arsia452/Cyberdeck_TD/CyberdeckKeyboard/production/bom.csv

Designator | Footprint | Quantity | Value | LCSC Part #
C1 | 0603 | 1 | 100nF
C16, C17, C20 | 0603 | 3 | 4.7uF
C18 | 0603 | 1 | 1uF
C19, C26, C27 | 0603 | 3 | 10uF
C3, C5 | 0603 | 2 | 12pF
D1, D10, D11, D12, D13, D14, D15, D16, D17, D18, D19, D2, D20, D21, D22, D23, D24, D25, D26, D27, D28, D29, D3, D30, D31, D32, D33, D34, D35, D36, D37, D38, D39, D4, D40, D41, D42, D43, D44, D45, D46, D47, D48, D49, D5, D50, D51, D52, D53, D54, D55, D56, D57, D58, D59, D6, D60, D61, D62, D63, D7, D8, D9 | Diode_SOD-123 | 63 | ~
D64 | 1206 | 1 | LED Blue
D65 | 1206 | 1 | LED Orange
J1 | SolderWirePad_1x01_SMD_2x4mm | 1 | GND_Pad_TKPD
J2 | USB_C_Receptacle_GCT_USB4105-xx-A_16P_TopMnt_Horizontal | 1 | USB C Recepticle
J3 | JST_PH_B2B-PH-K_1x02_P2.00mm_Vertical | 1 | Conn_01x02
J5 | SolderWirePad_1x01_SMD_2x4mm | 1 | SCL_Pad_TKPD
J6 | SolderWirePad_1x01_SMD_2x4mm | 1 | SDA_Pad_TKPD
J7 | SolderWirePad_1x01_SMD_2x4mm | 1 | VCC_Pad_TKPD
JP1 | SolderJumper-2_P1.3mm_Open_Pad1.0x1.5mm | 1 | Charge Boost
L6 | 0603 | 1 | 10uH
R1 | 0603 | 1 | 2.2Ω
R10, R3, R4, R5 | 0603 | 4 | 10kΩ
R2 | 0603 | 1 | 1kΩ
R6 | 0603 | 1 | 2kΩ
R7 | 0603 | 1 | 10MΩ
R8 | 0603 | 1 | 5.1kΩ
R9 | 0603 | 1 | 5.1κΩ
S1, S10, S11, S12, S13, S14, S15, S16, S17, S18, S19, S2, S20, S21, S22, S23, S24, S25, S26, S27, S28, S29, S3, S30, S31, S33, S35, S36, S37, S38, S39, S4, S40, S41, S42, S43, S44, S45, S46, S47, S48, S49, S5, S50, S51, S52, S53, S54, S55, S56, S57, S58, S59, S6, S60, S61, S62, S63, S7, S8, S9 | Choc_V1V2_1.00u | 61 | ~
SW1 | SW_SPST_CK_RS282G05A3 | 1 | RST_SW
U2 | VQFN-16-1EP_3x3mm_P0.5mm_EP1.6x1.6mm | 1 | BQ24075RGT
U3 | SOT-23-5 | 1 | XC6220B331MR
Y3 | Crystal_SMD_2012-2Pin_2.0x1.2mm | 1 | 32.768kHz FC-12M
