arsia452/Cyberdeck_TD/1217AS-H-4R7N_P3/1217AS-H-4R7N_P3.step

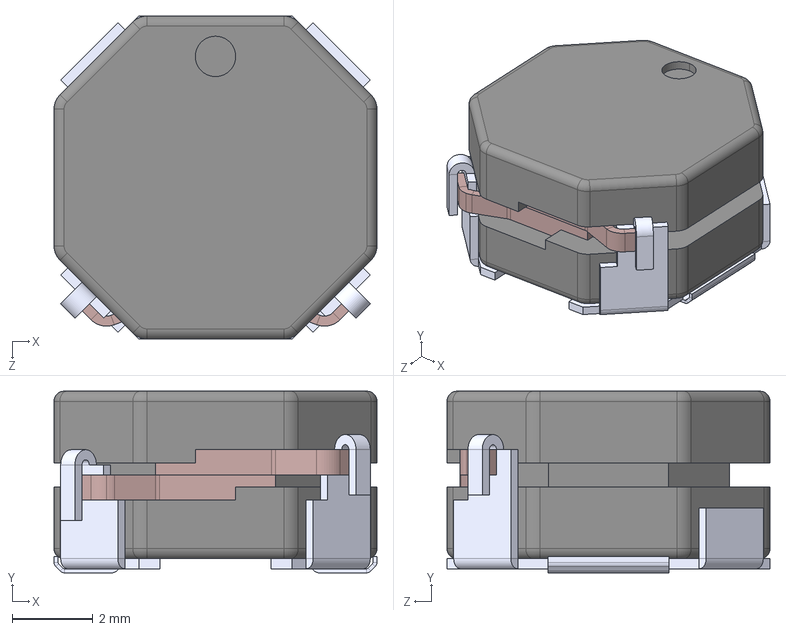
[picture p1: CAD file, 2026-10-16]
1217AS-H-4R7N_P3/1217AS-H-4R7N_P3.step
8.00 x 4.50 x 8.00 mm
