arsia452/Cyberdeck_TD/3D_models/SO-DIMM.stp

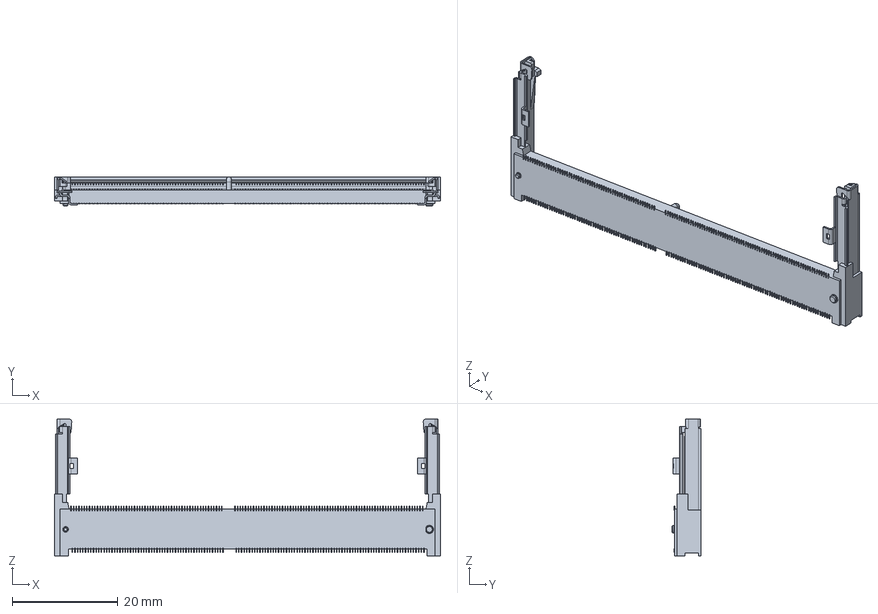
[picture p2: CAD file, 2026-10-16]
3D_models/SO-DIMM.stp
73.0 x 5.55 x 25.9 mm
