arsia452/Cyberdeck_TD/Cyberdeck_TD_Carrier/FDMC8327L/WDFN8_511DR_OSI.step

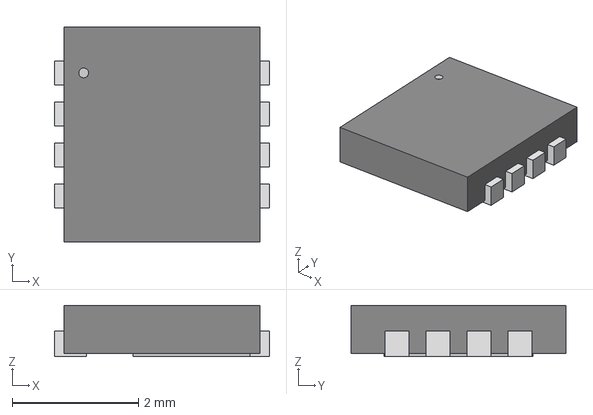
[picture p3: CAD file, 2026-10-16]
Cyberdeck_TD_Carrier/FDMC8327L/WDFN8_511DR_OSI.step
3.40 x 3.40 x 0.815 mm
