arsia452/Cyberdeck_TD/Cyberdeck_TD_Carrier/VLS6045EX_4R7M/IND_VLS6045EX-4R7M_TDK.step

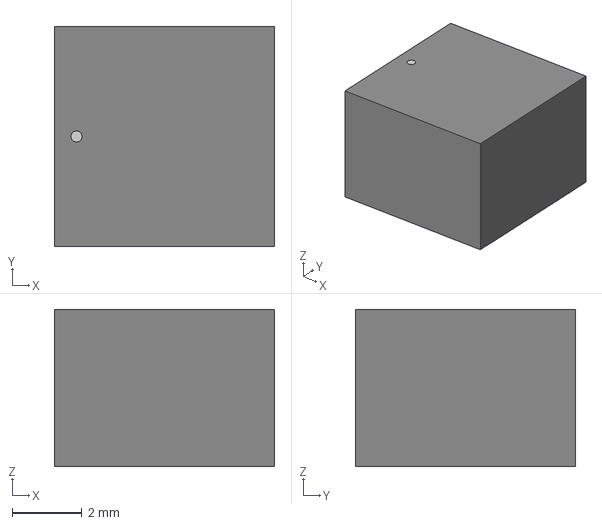
[picture p4: CAD file, 2026-10-16]
Cyberdeck_TD_Carrier/VLS6045EX_4R7M/IND_VLS6045EX-4R7M_TDK.step
6.30 x 6.30 x 4.50 mm
