arsia452/Cyberdeck_TD/CyberdeckKeyboard/CyberdeckKeyboard.step

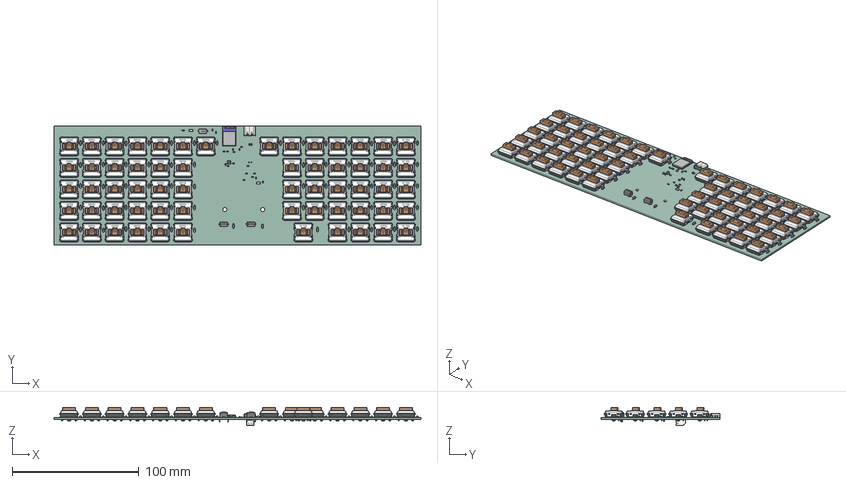
[picture p5: CAD file, 2026-10-16]
CyberdeckKeyboard/CyberdeckKeyboard.step
290.0 x 94.0 x 14.6 mm
Diode_SOD-123 x 63
Choc_V1 x 61
USB_C_Receptacle_GCT_USB4105-xx-A_16P_TopMnt_Horizontal
SW_PUSH_1P1T_6x3.5mm_H4.3_APEM_MJTP1243 x 2
R_0603_1608Metric x 10
C_0603_1608Metric x 10
Raytac_MDBT50Q
SOT-23-5
LED_1206_3216Metric x 2
L_0603_1608Metric
SW_SPST_CK_RS282G05A3
JST_PH_S2B-PH-K_1x02_P2.00mm_Horizontal
CyberdeckKeyboard_PCB
