arsia452/Cyberdeck_TD/3D_models/MDT420E02001.step

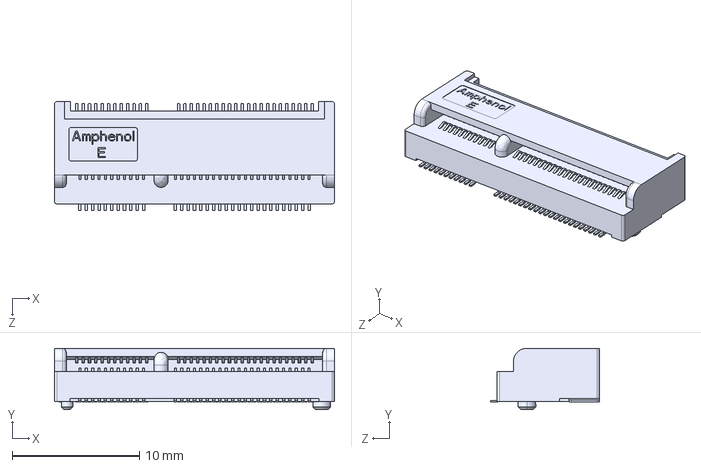
[picture p7: CAD file, 2026-10-16]
3D_models/MDT420E02001.step
22.0 x 4.80 x 8.55 mm
