arsia452/Cyberdeck_TD/3D_models/2086581001.step

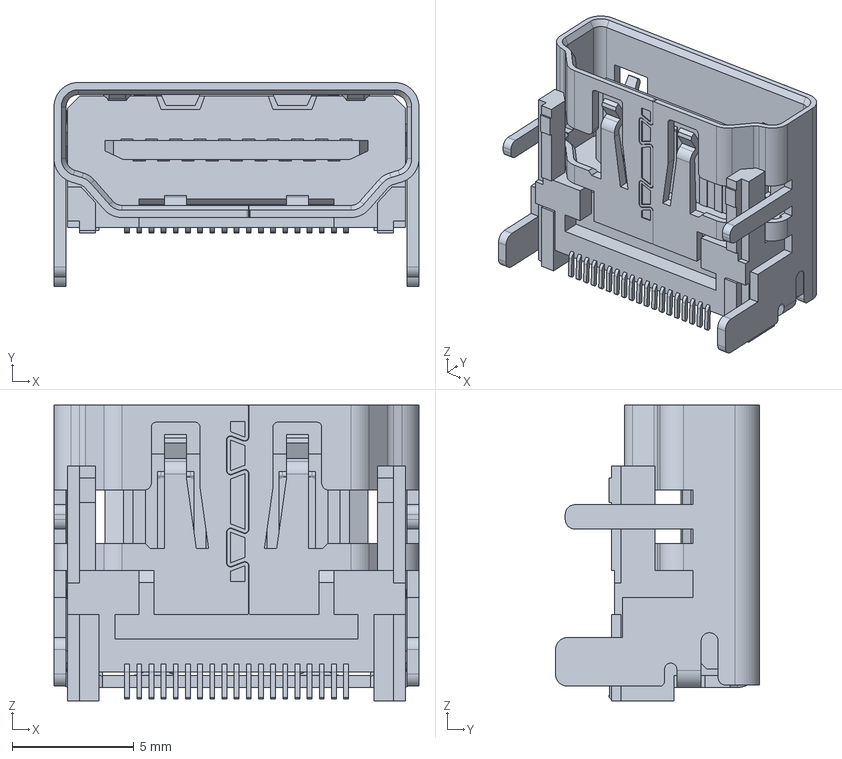
[picture p8: CAD file, 2026-10-16]
3D_models/2086581001.step
15.0 x 8.38 x 12.2 mm
