arsia452/Cyberdeck_TD/Cyberdeck_TD_Carrier/Cyberdeck_TD_Carrier.kicad_pcb

## KiCad design Cyberdeck_TD_Carrier/Cyberdeck_TD_Carrier.kicad_pcb (2026-10-19)

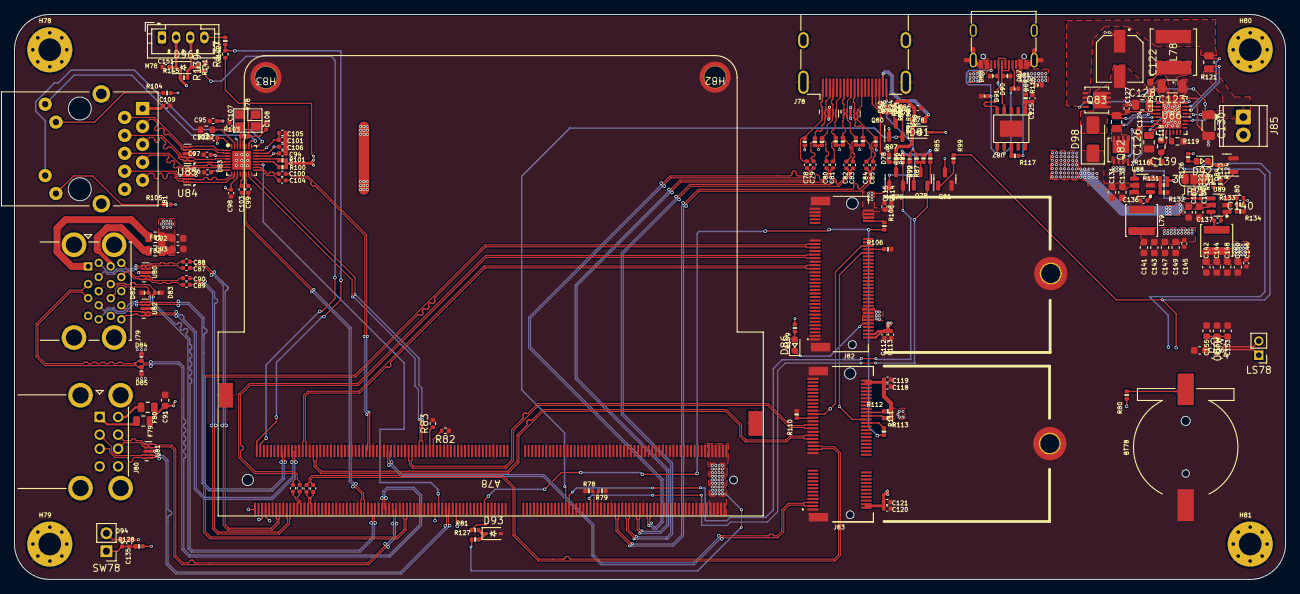
[picture p9: board Cyberdeck_TD_Carrier.kicad_pcb from above]

Board: 4 copper layers, 180.0 x 80.0 mm, 205 parts (0 on the bottom side), 166 nets.

Parts:
A78: LattePanda_Mu; LattePanda_Module_H8.0mm_Horizontal
BT78: Battery_Cell; Battery_Holder_CR1220_S8411-45R
C78, C79, C80, C81, C82, C83, C84, C85, C86, C87, C88, C89, C90, C94, C95, C96, C97, C98, C99, C100, C101, C102, C103, C104, C106, C109, C113, C115, C119, C121, C136, C137, C145, C146, C151: 100nF/50V; C_0402_1005Metric
C91, C92, C93, C131, C132, C133, C134, C141, C142, C143, C144, C147, C148, C149, C150: 22uF/10V; C_0603_1608Metric
C105, C112, C114, C118, C120: 10uF/10V; C_0402_1005Metric
C107, C108, C139, C140: 12pF/50V; C_0402_1005Metric
C110, C111, C116, C117: 220nF/50V; C_0402_1005Metric
C122: 47uF; CAP_EEEFH1E470XL
C123, C130: 10uF; C_1206_3216Metric
C124, C127: 0.1uF; C_0402_1005Metric
C125, C135: 1uF/16V; C_0402_1005Metric
C126: 1uF; C_0805_2012Metric
C128: 10uF; C_0805_2012Metric
C129: 22nF; C_0603_1608Metric
C153: 100uF; C_0603_1608Metric
C154: 10uF; C_0603_1608Metric
C155, C156: 1uF; C_0603_1608Metric
D78, D79, D80, D82, D83, D84, D85, D87, D88, D94: ESD5V0B03; D_0402_1005Metric
D81, D96: 1N5819WS; D_SOD-323
D86, D92: LED_G; LED_0603_1608Metric
D89, D90, D91: PESD24VS1UL-N; D_0402_1005Metric
D93: 3V3 Izt=5mA; D_SOD-323
D98: D_TVS; D_SMA
F78: 6V/50mA; R_0603_1608Metric
F79, F80: 6V/1A; Fuse_0805_2012Metric
F81: 6V/2A; R_0805_2012Metric
F82: 6V/2A; Fuse_0805_2012Metric
H78, H79, H80, H81: MountingHole_Pad; MountingHole_3.2mm_M3_Pad_Via
H82, H83: MountingHole_Pad; MountingHole_3mm_M2_Pad_TopOnly
H84, H85: MountingHole_M2.0; MountingHole_2.7mm_M2.5_DIN965_Pad_TopOnly
J78: HDMI_A; HDMI_A_Molex_208658-1001_Horizontal
J79: USB3_A_Stacked; USB3_A_Molex_48406-0001_Horizontal_Stacked
J80: USB_A_Stacked; USB_A_CUI_UJ2-ADH-TH_Horizontal_Stacked
J81: RJ45_RB1-125B8G1A; RJ45_UDE_RB1-125B8G1A
J82: Bus_M.2_Socket_M; PCIe_M.2_Connectors_P=0.5mm_H=4.2mm_KeyM
J83: Bus_M.2_Socket_E; PCIe_M.2_Connectors_P=0.5mm_H=4.2mm_KeyE
J84: USB_C_Receptacle_USB2.0; USB_C_Receptacle_G-Switch_GT-USB-7010ASV
J85: BAT_TERM; TerminalBlock_TE_282834-2_1x02_P2.54mm_Horizontal
JP78: SolderJumper_3_Open; SolderJumper-3_P1.3mm_Bridged2Bar12_RoundedPad1.0x1.5mm_Num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
L78: 4.7uH; IND_VLS6045EX-4R7M_TDK
L79, L80: 2.2uH/4.3A; L_Sunlord_SWPA4020S
LS78: Speaker; PinHeader_1x02_P2.00mm_Vertical
M78: Fan_4pin; JST_PH_B4B-PH-K_1x04_P2.00mm_Vertical
Q78, Q84: 2N7002; SOT-23
Q79, Q80, Q81: 2SK3018; SOT-23
Q82, Q83: FDMC8327L; WDFN8_511DR_OSI
R78, R79, R125: 100K/1%; R_0402_1005Metric
R80, R92, R115, R123: 1K/1%; R_0402_1005Metric
R81, R82, R83, R100, R101, R112, R113, R117, R124, R132: 10K/1%; R_0402_1005Metric
R84, R86, R95, R98, R99, R109, R126, R127: 2.2K/1%; R_0402_1005Metric
R85, R103: 1M/1%; R_0402_1005Metric
R87, R133, R139, R141: 21.5K/1%; R_0402_1005Metric
R88, R89, R90, R91, R93, R94, R96, R97, R104, R105: 470R/1%; R_0402_1005Metric
R102: 2.49K/1%; R_0603_1608Metric
R106, R108, R110, R111: 0R/1%; R_0402_1005Metric
R114: 6.8mΩ; R_0805_2012Metric
R116, R118: 10kΩ; R_0603_1608Metric
R119: 63.4kΩ; R_0603_1608Metric
R121: 10mΩ; R_0805_2012Metric
R122, R128, R142: 100R/1%; R_0402_1005Metric
R131: 75K/1%; R_0402_1005Metric
R134, R137, R145: 4.7K/1%; R_0402_1005Metric
SW78: PWR_BTN; PinHeader_1x02_P2.54mm_Vertical
U78, U79: TPAZ1023-04F; Diodes_UDFN-10_1.0x2.5mm_P0.5mm
U80, U81, U82, U84, U85: ULC0524P; Diodes_UDFN-10_1.0x2.5mm_P0.5mm
U83: RTL8111H-CG-RH; QFN-32-1EP_4x4mm_P0.4mm_EP2.65x2.65mm
U86: LTC4162-L42; 05-08-1712_ADI-L
U87: CH224K; ESSOP-10-1EP_3.9x5mm_P1.0mm_EP3.2x2.3
U88, U89: SY8253ADC; TSOT-23-6
U90: MAX98365AEWC+; 21-100536_W121D1&plus_1_MXM
Y78: 25MHz; Crystal_SMD_3225-4Pin_3.2x2.5mm

Connections:
5V_HDMI_VCC: C86.1, D81.1 (K), F78.1, R95.1, R98.1
+1V0: C94.2, C95.2, C96.2, C97.2, C101.2, C105.2, U83.3 (AVDD10), U83.8 (AVDD10), U83.22 (DVDD10), U83.24 (REGOUT), U83.30 (AVDD10)
+3V3: C98.2, C102.2, C106.2, C112.2, C113.2, C114.2, C115.2, C118.2, C119.2, C120.2, C121.2, C140.1, C142.2, C144.2, C146.1, C148.2, C150.2, J82.2 (3.3V), J82.4 (3.3V), J82.12 (3.3V), J82.14 (3.3V), J82.16 (3.3V), J82.18 (3.3V), J82.70 (3.3V), J82.72 (3.3V), J82.74 (3.3V), J83.2 (3.3V), J83.4 (3.3V), J83.72 (3.3V), J83.74 (3.3V), L80.2, Q78.1 (G), Q79.1 (G), Q80.1 (G), R84.1, R85.1, R86.1, R100.1, R101.1, R104.2, R105.2, R109.2, R112.2, R113.1, R126.2, R133.2, R137.1, U83.11 (AVDD33), U83.23 (VDDREG), U83.32 (AVDD33)
+5V: C91.2, C92.2, C93.2, C139.1, C141.2, C143.2, C145.1, C147.2, C149.2, C151.1, D81.2 (A), D96.1 (K), F79.1, F80.1, F81.1, F82.1, L79.2, M78.2 (+), R131.2, R145.1
+BATT: A78.115 (VBAT), R80.1
/Fan_Temp/FAN_1_PWM: A78.2 (FAN1_PWM), R137.2, R142.1
/Fan_Temp/FAN_1_TAC: A78.4 (FAN1_TAC), R139.1, R141.2
/Gigabit Ethernet/GbE_PCIe_CLK+: A78.94 (REFCLK4+), U83.15 (REFCLK_P)
/Gigabit Ethernet/GbE_PCIe_CLK-: A78.96 (REFCLK4-), U83.16 (REFCLK_N)
/Gigabit Ethernet/GbE_PCIe_RX+: A78.64 (HSIO6_RX+), C104.2
/Gigabit Ethernet/GbE_PCIe_RX-: A78.66 (HSIO6_RX-), C100.2
/Gigabit Ethernet/GbE_PCIe_TX+: A78.61 (HSIO6_TX+), C103.2
/Gigabit Ethernet/GbE_PCIe_TX-: A78.63 (HSIO6_TX-), C99.2
/Gigabit Ethernet/HSI+: C103.1, U83.13 (HSIP)
/Gigabit Ethernet/HSI-: C99.1, U83.14 (HSIN)
/Gigabit Ethernet/HSO+: C104.1, U83.17 (HSOP)
/Gigabit Ethernet/HSO-: C100.1, U83.18 (HSON)
/Gigabit Ethernet/LED1_1000: J81.L4, U83.26 (LED1)
/Gigabit Ethernet/LED2_ACT: J81.L2, U83.25 (LED2)
/Gigabit Ethernet/MDI0+: J81.R2 (TD1+), U83.1 (MDIP0), U85.5, U85.6 (NC)
/Gigabit Ethernet/MDI0-: J81.R3 (TD1-), U83.2 (MDIN0), U85.4, U85.7 (NC)
/Gigabit Ethernet/MDI1+: J81.R4 (TD2+), U83.4 (MDIP1), U85.2, U85.9 (NC)
/Gigabit Ethernet/MDI1-: J81.R5 (TD2-), U83.5 (MDIN1), U85.1, U85.10 (NC)
/Gigabit Ethernet/MDI2+: J81.R6 (TD3+), U83.6 (MDIP2), U84.5, U84.6 (NC)
/Gigabit Ethernet/MDI2-: J81.R7 (TD3-), U83.7 (MDIN2), U84.4, U84.7 (NC)
/Gigabit Ethernet/MDI3+: J81.R8 (TD4+), U83.9 (MDIP3), U84.2, U84.9 (NC)
/Gigabit Ethernet/MDI3-: J81.R9 (TD4-), U83.10 (MDIN3), U84.1, U84.10 (NC)
/HDMI/DDC_SCL: D78.2 (A2), J78.15 (SCL), Q79.3 (D), R95.2
/HDMI/DDC_SDA: D80.2 (A2), J78.16 (SDA), Q80.3 (D), R98.2
/HDMI/DDI_B_DDC_SCL: A78.171 (DDIB_DDC_SCL), Q79.2 (S), R86.2
/HDMI/DDI_B_DDC_SDA: A78.169 (DDIB_DDC_SDA), Q80.2 (S), R84.2
/HDMI/DDI_B_HPD: A78.183 (DDIB_HPD), Q78.2 (S), R85.2
/HDMI/DDI_B_TX0+: A78.217 (DDIB_TX0+), C78.1
/HDMI/DDI_B_TX0-: A78.215 (DDIB_TX0-), C79.1
/HDMI/DDI_B_TX1+: A78.211 (DDIB_TX1+), C80.1
/HDMI/DDI_B_TX1-: A78.209 (DDIB_TX1-), C81.1
/HDMI/DDI_B_TX2+: A78.205 (DDIB_TX2+), C82.1
/HDMI/DDI_B_TX2-: A78.203 (DDIB_TX2-), C83.1
/HDMI/DDI_B_TX3+: A78.199 (DDIB_TX3+), C84.1
/HDMI/DDI_B_TX3-: A78.197 (DDIB_TX3-), C85.1
/HDMI/HPD: D79.2 (A2), J78.19 (HPD), R92.2
/HDMI/TMDS_CK+: C84.2, J78.10 (CK+), R89.1, U79.4, U79.7 (NC)
/HDMI/TMDS_CK-: C85.2, J78.12 (CK-), R88.1, U79.5, U79.6 (NC)
/HDMI/TMDS_D0+: C82.2, J78.7 (D0+), R91.1, U79.1, U79.10 (NC)
/HDMI/TMDS_D0-: C83.2, J78.9 (D0-), R90.1, U79.2, U79.9 (NC)
/HDMI/TMDS_D1+: C80.2, J78.4 (D1+), R94.1, U78.4, U78.7 (NC)
/HDMI/TMDS_D1-: C81.2, J78.6 (D1-), R93.1, U78.5, U78.6 (NC)
/HDMI/TMDS_D2+: C78.2, J78.1 (D2+), R97.1, U78.1, U78.10 (NC)
/HDMI/TMDS_D2-: C79.2, J78.3 (D2-), R96.1, U78.2, U78.9 (NC)
/LattePanda Module/HSIO_0_TX+: A78.13 (HSIO0_TX+), C88.1
/LattePanda Module/HSIO_0_TX-: A78.15 (HSIO0_TX-), C87.1
/LattePanda Module/HSIO_1_TX+: A78.19 (HSIO1_TX+), C90.1
/LattePanda Module/HSIO_1_TX-: A78.21 (HSIO1_TX-), C89.1
/LattePanda Module/HSIO_2_RX+: A78.28 (HSIO2_RX+), J82.43 (PERp0/SATA-B-)
/LattePanda Module/HSIO_2_RX-: A78.30 (HSIO2_RX-), J82.41 (PERn0/SATA-B+)
/LattePanda Module/HSIO_2_TX+: A78.25 (HSIO2_TX+), C110.1
/LattePanda Module/HSIO_2_TX-: A78.27 (HSIO2_TX-), C111.1
/LattePanda Module/HSIO_3_RX+: A78.34 (HSIO3_RX+), J83.41 (PERp0)
/LattePanda Module/HSIO_3_RX-: A78.36 (HSIO3_RX-), J83.43 (PERn0)
/LattePanda Module/HSIO_3_TX+: A78.31 (HSIO3_TX+), C116.1
/LattePanda Module/HSIO_3_TX-: A78.33 (HSIO3_TX-), C117.1
/LattePanda Module/REFCLK0+: A78.85 (REFCLK0+), J82.53 (REFCLKn)
/LattePanda Module/REFCLK0-: A78.87 (REFCLK0-), J82.55 (REFCLKp)
/LattePanda Module/REFCLK3+: A78.88 (REFCLK3+), J83.47 (REFCLKp0)
/LattePanda Module/REFCLK3-: A78.90 (REFCLK3-), J83.49 (REFCLKn0)
/LattePanda Module/SLS_S3: A78.7 (SLS_S3), JP78.3 (B)
/LattePanda Module/SUSCLK_WIFI: A78.131 (SUSCLK), R108.2, R111.2
/LattePanda Module/USB_2_P7+: A78.76 (USB2_P7+), J83.3 (USB_D+)
/LattePanda Module/USB_2_P7-: A78.78 (USB2_P7-), J83.5 (USB_D-)
/LattePanda Module/~PWR_SW: A78.1 (~PWRBTN), R128.2
/M.2 E&M Key/CON_PCIE_TX_0+: C116.2, J83.35 (PETp0)
/M.2 E&M Key/CON_PCIE_TX_0-: C117.2, J83.37 (PETn0)
/M.2 E&M Key/CON_PCIE_TX_1+: C110.2, J82.49 (PETp0/SATA-A+)
/M.2 E&M Key/CON_PCIE_TX_1-: C111.2, J82.47 (PETn0/SATA-A-)
/M.2 E&M Key/~CLKREQE: J83.53 (~CLKREQ0), R110.1
/M.2 E&M Key/~CLKREQM: J82.52 (~CLKREQ), R106.1
/PSU/BAT(+): C130.1, J85.1 (B(+)), R121.2, U86.19 (BATSENS+), U86.20 (CSN)
/PSU/BATFET: Q83.4, U86.22 (BATFET)
/PSU/BIAS: R118.2, U86.9 (NTCBIAS)
/PSU/BOOST: C129.2, U86.1 (BOOST)
/PSU/CC1: D90.1 (K), J84.A5 (CC1), U87.7 (CC1)
/PSU/CC2: D91.1 (K), J84.B5 (CC2), U87.6 (CC2)
/PSU/CELLS0: C128.2, U86.2 (INTVCC), U86.17 (CELLS0)
/PSU/CELLS1: C126.2, U86.8 (VCC2P5), U86.18 (CELLS1)
/PSU/CLP: Q82.5, Q82.6, Q82.7, Q82.8, R114.2, U86.5 (CLP)
/PSU/CSP: L78.2, Q83.1, Q83.2, Q83.3, R121.1, U86.21 (CSP)
/PSU/INFET: Q82.4, U86.6 (INFET)
/PSU/NTC: R116.1, R118.1, U86.10 (NTC)
/PSU/PWR_C_D+: D88.2 (A2), J84.A6 (D+), J84.B6 (D+), U87.4 (DP)
/PSU/PWR_C_D-: D87.2 (A2), J84.A7 (D-), J84.B7 (D-), U87.5 (DM)
/PSU/PWR_EN: R122.2, R125.2, U88.4 (EN), U89.4 (EN)
/PSU/RT: R119.1, U86.11 (RT)
/PSU/SW: C129.1, L78.1, U86.25 (SW), U86.26 (SW)
/PSU/VBUS: C124.1, D89.1 (K), J84.A4 (VBUS), J84.A9 (VBUS), J84.B4 (VBUS), J84.B9 (VBUS), Q82.1, Q82.2, Q82.3, R115.1, R117.1, U86.7 (VIN)
/USB2.0&USB3.0/CON_USB1_D_N: A78.109 (USB2_P5-), J80.2 (D1-), U81.2, U81.9 (NC)
/USB2.0&USB3.0/CON_USB1_D_P: A78.111 (USB2_P5+), J80.3 (D1+), U81.1, U81.10 (NC)
/USB2.0&USB3.0/CON_USB2_D_N: A78.79 (USB2_P3-), J80.6 (D2-), U81.5, U81.6 (NC)
/USB2.0&USB3.0/CON_USB2_D_P: A78.81 (USB2_P3+), J80.7 (D2+), U81.4, U81.7 (NC)
/USB2.0&USB3.0/CON_USB3_D_N: A78.73 (USB2_P2-), D85.2 (A2), J79.2 (D1-)
/USB2.0&USB3.0/CON_USB3_D_P: A78.75 (USB2_P2+), D84.2 (A2), J79.3 (D1+)
/USB2.0&USB3.0/CON_USB3_SSRX_N: A78.18 (HSIO0_RX-), J79.5 (SSRX1-), U82.4, U82.7 (NC)
/USB2.0&USB3.0/CON_USB3_SSRX_P: A78.16 (HSIO0_RX+), J79.6 (SSRX1+), U82.5, U82.6 (NC)
/USB2.0&USB3.0/CON_USB3_SSTX_N: C87.2, J79.8 (SSTX1-), U80.4, U80.7 (NC)
/USB2.0&USB3.0/CON_USB3_SSTX_P: C88.2, J79.9 (SSTX1+), U80.5, U80.6 (NC)
/USB2.0&USB3.0/CON_USB4_D_N: A78.67 (USB2_P1-), D83.2 (A2), J79.11 (D2-)
/USB2.0&USB3.0/CON_USB4_D_P: A78.69 (USB2_P1+), D82.2 (A2), J79.12 (D2+)
/USB2.0&USB3.0/CON_USB4_SSRX_N: A78.24 (HSIO1_RX-), J79.14 (SSRX2-), U82.1, U82.10 (NC)
/USB2.0&USB3.0/CON_USB4_SSRX_P: A78.22 (HSIO1_RX+), J79.15 (SSRX2+), U82.2, U82.9 (NC)
/USB2.0&USB3.0/CON_USB4_SSTX_N: C89.2, J79.17 (SSTX2-), U80.1, U80.10 (NC)
/USB2.0&USB3.0/CON_USB4_SSTX_P: C90.2, J79.18 (SSTX2+), U80.2, U80.9 (NC)
/~PLT_RST: A78.105 (~PLTRST), J82.50 (~PERST), J83.52 (~PERST0), U83.19 (PERSTB)
/~PWR_LED/~PSON: A78.5 (SLS_S0), JP78.1 (A), R99.1, R123.1
/~WAKE: A78.103 (~WAKE), J82.54 (~PEWAKE), J83.55 (~PEWAKE0)
AUDIO: A78.166 (I2S_TXD), U90.B4 (DAI1)
BCLK: A78.162 (I2S_SCLK), U90.C4 (DAI0)
FCLK: A78.164 (I2S_SFRM), U90.A4 (DAI2)
GND: A78.11 (GND), A78.14 (GND), A78.17 (GND), A78.20 (GND), A78.23 (GND), A78.26 (GND), A78.29 (GND), A78.32 (GND), A78.35 (GND), A78.38 (GND), A78.41 (GND), A78.44 (GND), A78.47 (GND), A78.50 (GND), A78.53 (GND), A78.56 (GND), A78.59 (GND), A78.62 (GND), A78.65 (GND), A78.68 (GND), A78.71 (GND), A78.74 (GND), A78.77 (GND), A78.80 (GND), A78.83 (GND), A78.86 (GND), A78.89 (GND), A78.92 (GND), A78.95 (GND), A78.98 (GND), A78.101 (GND), A78.107 (GND), A78.110 (GND), A78.113 (GND), A78.116 (GND), A78.135 (GND), A78.136 (GND), A78.151 (GND), A78.158 (GND), A78.167 (GND), A78.170 (GND), A78.181 (GND), A78.182 (GND), A78.188 (GND), A78.189 (GND), A78.194 (GND), A78.195 (GND), A78.200 (GND), A78.201 (GND), A78.206 (GND), A78.207 (GND), A78.212 (GND), A78.213 (GND), A78.218 (GND), A78.219 (GND), A78.224 (GND), A78.225 (GND), A78.230 (GND), A78.231 (GND), A78.236 (GND), A78.237 (GND), A78.242 (GND), A78.243 (GND), A78.248 (GND), A78.249 (GND), A78.MP (Mountinge_Pads), BT78.2 (-), C86.2, C91.1, C92.1, C93.1, C94.1, C95.1, C96.1, C97.1, C98.1, C101.1, C102.1, C105.1, C106.1, C107.1, C108.1, C109.2, C112.1, C113.1, C114.1, C115.1, C118.1, C119.1, C120.1, C121.1, C122.1, C123.1, C124.2, C125.2, C126.1, C127.1, C128.1, C130.2, C131.1, C132.1, C133.1, C134.1, C135.2, C141.1, C142.1, C143.1, C144.1, C145.2, C146.2, C147.1, C148.1, C149.1, C150.1, C151.2, C153.1, C154.1, C155.1, C156.1, D78.1 (A1), D79.1 (A1), D80.1 (A1), D82.1 (A1), D83.1 (A1), D84.1 (A1), D85.1 (A1), D87.1 (A1), D88.1 (A1), D89.2 (A), D90.2 (A), D91.2 (A), D93.2 (A), D94.1 (A1), H78.1, H79.1, H80.1, H81.1, H82.1, H83.1, H84.1, H85.1, J78.2 (D2S), J78.5 (D1S), J78.8 (D0S), J78.11 (CKS), J78.17 (GND), J78.SH, J79.4 (GND1), J79.7 (DRAIN1), J79.13 (GND2), J79.16 (DRAIN2), J79.19 (SHIELD), J80.4 (GND1), J80.8 (GND2), J80.9 (Shield), J81.R10 (GND), J81.SH, J82.1 (GND), J82.3 (GND), J82.9 (GND), J82.15 (GND), J82.21 (GND), J82.27 (GND), J82.33 (GND), J82.39 (GND), J82.45 (GND), J82.51 (GND), J82.57 (GND), J82.71 (GND), J82.73 (GND), J82.75 (GND), J82.MP1, J82.MP2, J83.1 (GND), J83.7 (GND), J83.18 (GND), J83.33 (GND), J83.39 (GND), J83.45 (GND), J83.51 (GND), J83.57 (GND), J83.63 (GND), J83.69 (GND), J83.75 (GND), J83.MP1, J83.MP2, J84.A1 (GND), J84.A12 (GND), J84.B1 (GND), J84.B12 (GND), J84.S1 (SHIELD), J85.2 (B(-)), M78.1 (-), Q81.2 (S), Q84.2 (S), R78.2, R79.2, R82.2, R83.2, R87.2, R102.1, R106.2, R110.2, R116.2, R119.2, R124.1, R125.1, R132.1, R134.1, R139.2, SW78.2, U78.3 (VSS), U78.8 (VSS), U79.3 (VSS), U79.8 (VSS), U80.3 (VSS), U80.8 (VSS), U81.3 (VSS), U81.8 (VSS), U82.3 (VSS), U82.8 (VSS), U83.33 (GND), U84.3 (VSS), U84.8 (VSS), U85.3 (VSS), U85.8 (VSS), U86.16 (SYNC), U86.23 (PGND), U86.24 (PGND), U86.29 (AGND), U87.0 (GND), U88.2 (GND), U89.2 (GND), U90.B2 (GND), U90.C2 (GND), Y78.2, Y78.4
unnamed: A78.187 (TCP0_HPD), R78.1
unnamed: A78.185 (TCP1_HPD), R79.1
unnamed: A78.133 (~BIOS_SEL), R81.1
unnamed: A78.100 (~CLKREQ3), R83.1
unnamed: A78.102 (~CLKREQ4), R82.1
unnamed: BT78.1 (+), R80.2
unnamed: C153.2, C154.2, C155.2, U90.B1 (PVDD), U90.C1 (PVDD)
unnamed: D86.2 (A), R109.1
unnamed: D86.1 (K), J82.10 (DAS/~DSS/~LED1)
unnamed: D92.2 (A), R126.1
unnamed: D92.1 (K), Q84.3 (D)
unnamed: C135.1, D94.2 (A2), R128.1, SW78.1
unnamed: D96.2 (A), M78.3 (Tacho), R141.1, R145.2
unnamed: F78.2, J78.18 (+5V)
unnamed: F81.2, J79.1 (VBUS1)
unnamed: F82.2, J79.10 (VBUS2)
unnamed: F79.2, J80.1 (VBUS1)
unnamed: F80.2, J80.5 (VBUS2)
unnamed: C109.1, J81.R1 (CT)
unnamed: J81.L1, R105.1
unnamed: J81.L3, R104.1
unnamed: J82.68 (SUSCLK), R108.1
unnamed: J83.50 (SUSCLK), R111.1
unnamed: J83.56 (~W_DISABLE1), R112.1
unnamed: J83.54 (~W_DISABLE2), R113.2
unnamed: JP78.2 (C), R122.1
unnamed: M78.4 (PWM), R142.2
unnamed: Q78.3 (D), R87.1, R92.1
unnamed: Q81.3 (D), R88.2, R89.2, R90.2, R91.2, R93.2, R94.2, R96.2, R97.2
unnamed: Q81.1 (G), R99.2
unnamed: Q84.1 (G), R123.2, R124.2
unnamed: C108.2, R103.2, U83.28 (CKXTAL1), Y78.1
unnamed: C107.2, R103.1, U83.29 (CKXTAL2), Y78.3
unnamed: R100.2, U83.20 (ISOLATEB)
unnamed: R101.2, U83.21 (LANWAKEB)
unnamed: R102.2, U83.31 (RSET)
unnamed: R117.2, U87.8 (VBUS)
unnamed: C125.1, R115.2, U87.1 (VDD)
unnamed: C136.2, U88.1 (BOOST)
unnamed: C139.2, R131.1, R132.2, U88.3 (FB)
unnamed: C136.1, L79.1, U88.6 (SW)
unnamed: C137.2, U89.1 (BOOST)
unnamed: C140.2, R133.1, R134.2, U89.3 (FB)
unnamed: C137.1, L80.1, U89.6 (SW)
unnamed: LS78.1, U90.A2 (OUTN)
unnamed: LS78.2, U90.A1 (OUTP)
unnamed: C156.2, U90.C3 (VDD)
VDC: A78.250 (VIN), A78.251 (VIN), A78.252 (VIN), A78.253 (VIN), A78.254 (VIN), A78.255 (VIN), A78.256 (VIN), A78.257 (VIN), A78.258 (VIN), A78.259 (VIN), A78.260 (VIN), C122.2, C123.2, C127.2, C131.2, C132.2, C133.2, C134.2, D98.1 (A1), D98.2 (A2), Q83.5, Q83.6, Q83.7, Q83.8, R114.1, R127.1, U86.3 (VOUTA), U86.4 (CLN), U86.27 (VOUT), U86.28 (VOUT), U88.5 (VIN), U89.5 (VIN)
VPullup: D93.1 (K), R81.2, R127.2
