arsia452/Cyberdeck_TD/CyberdeckKeyboard/CyberdeckKeyboard.kicad_pcb

## KiCad design CyberdeckKeyboard/CyberdeckKeyboard.kicad_pcb (2026-10-16)

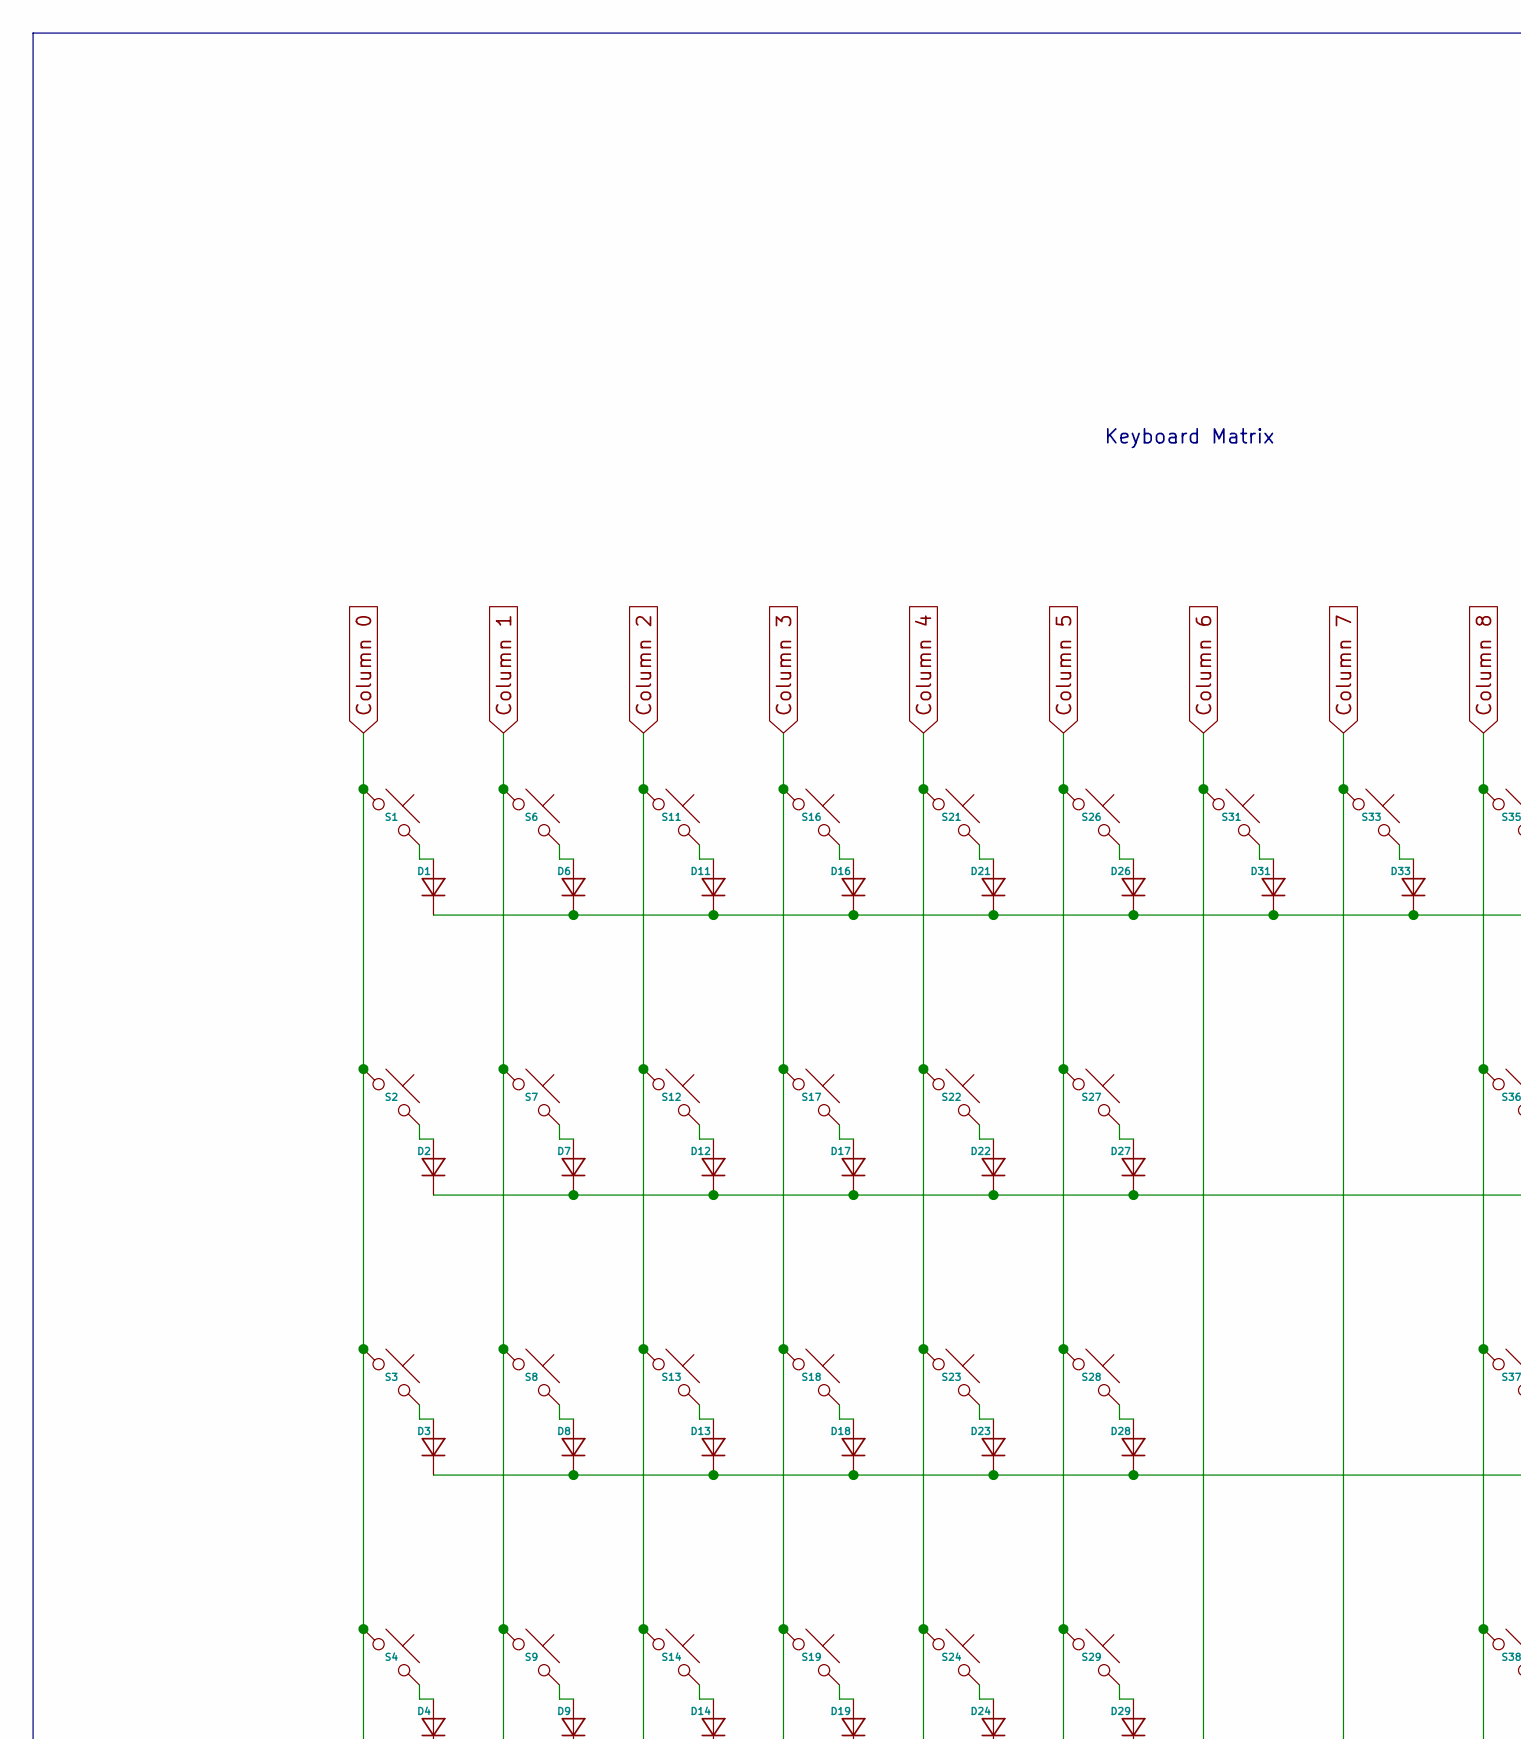
[picture p10: schematic CyberdeckKeyboard.kicad_sch, part in row 1, column 1]

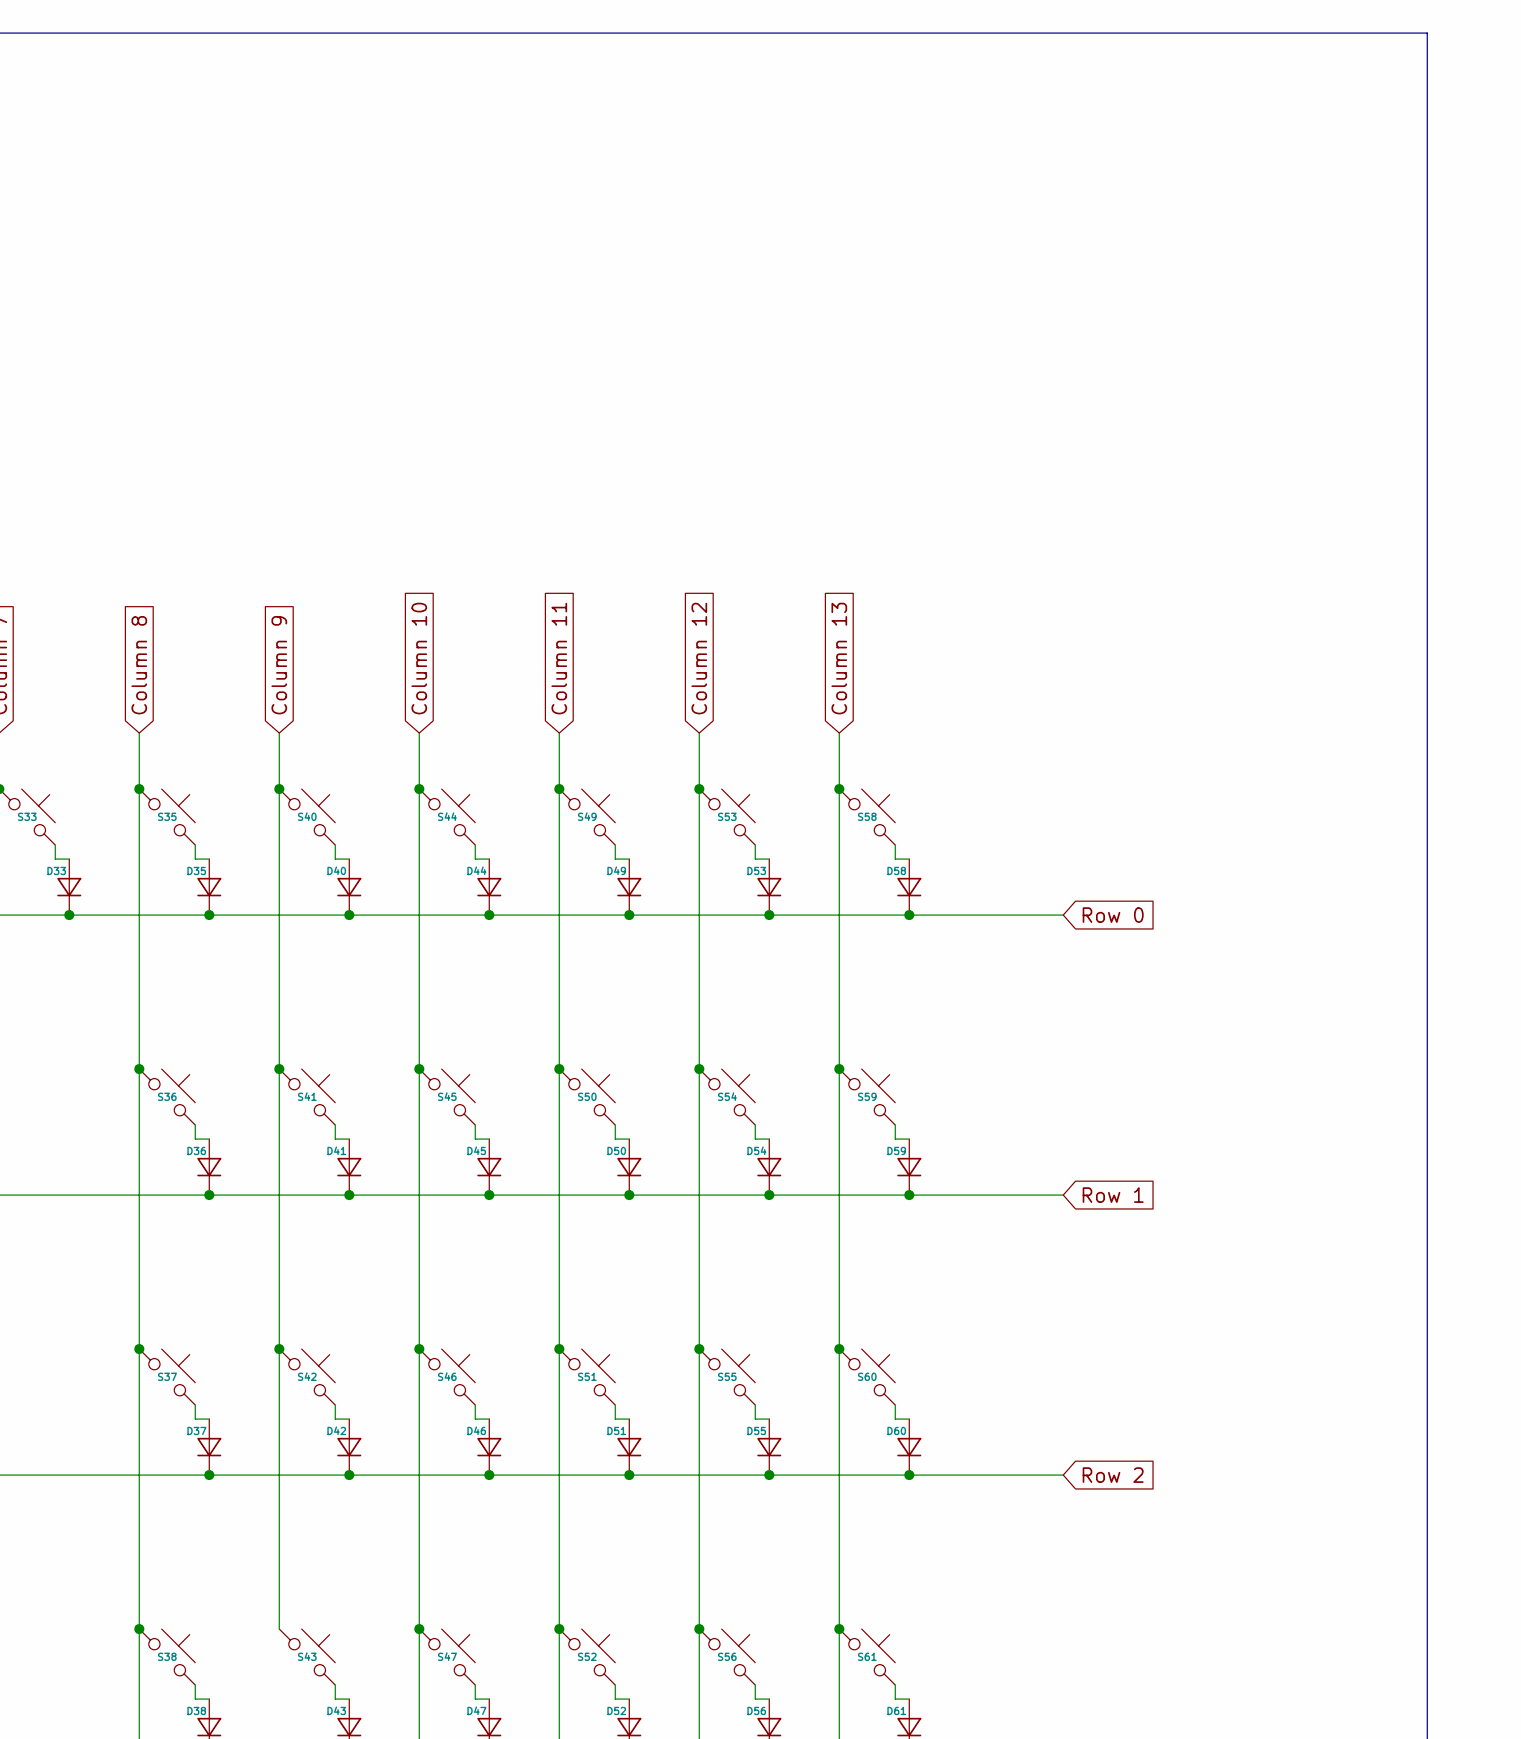
[picture p11: schematic CyberdeckKeyboard.kicad_sch, part in row 1, column 2]

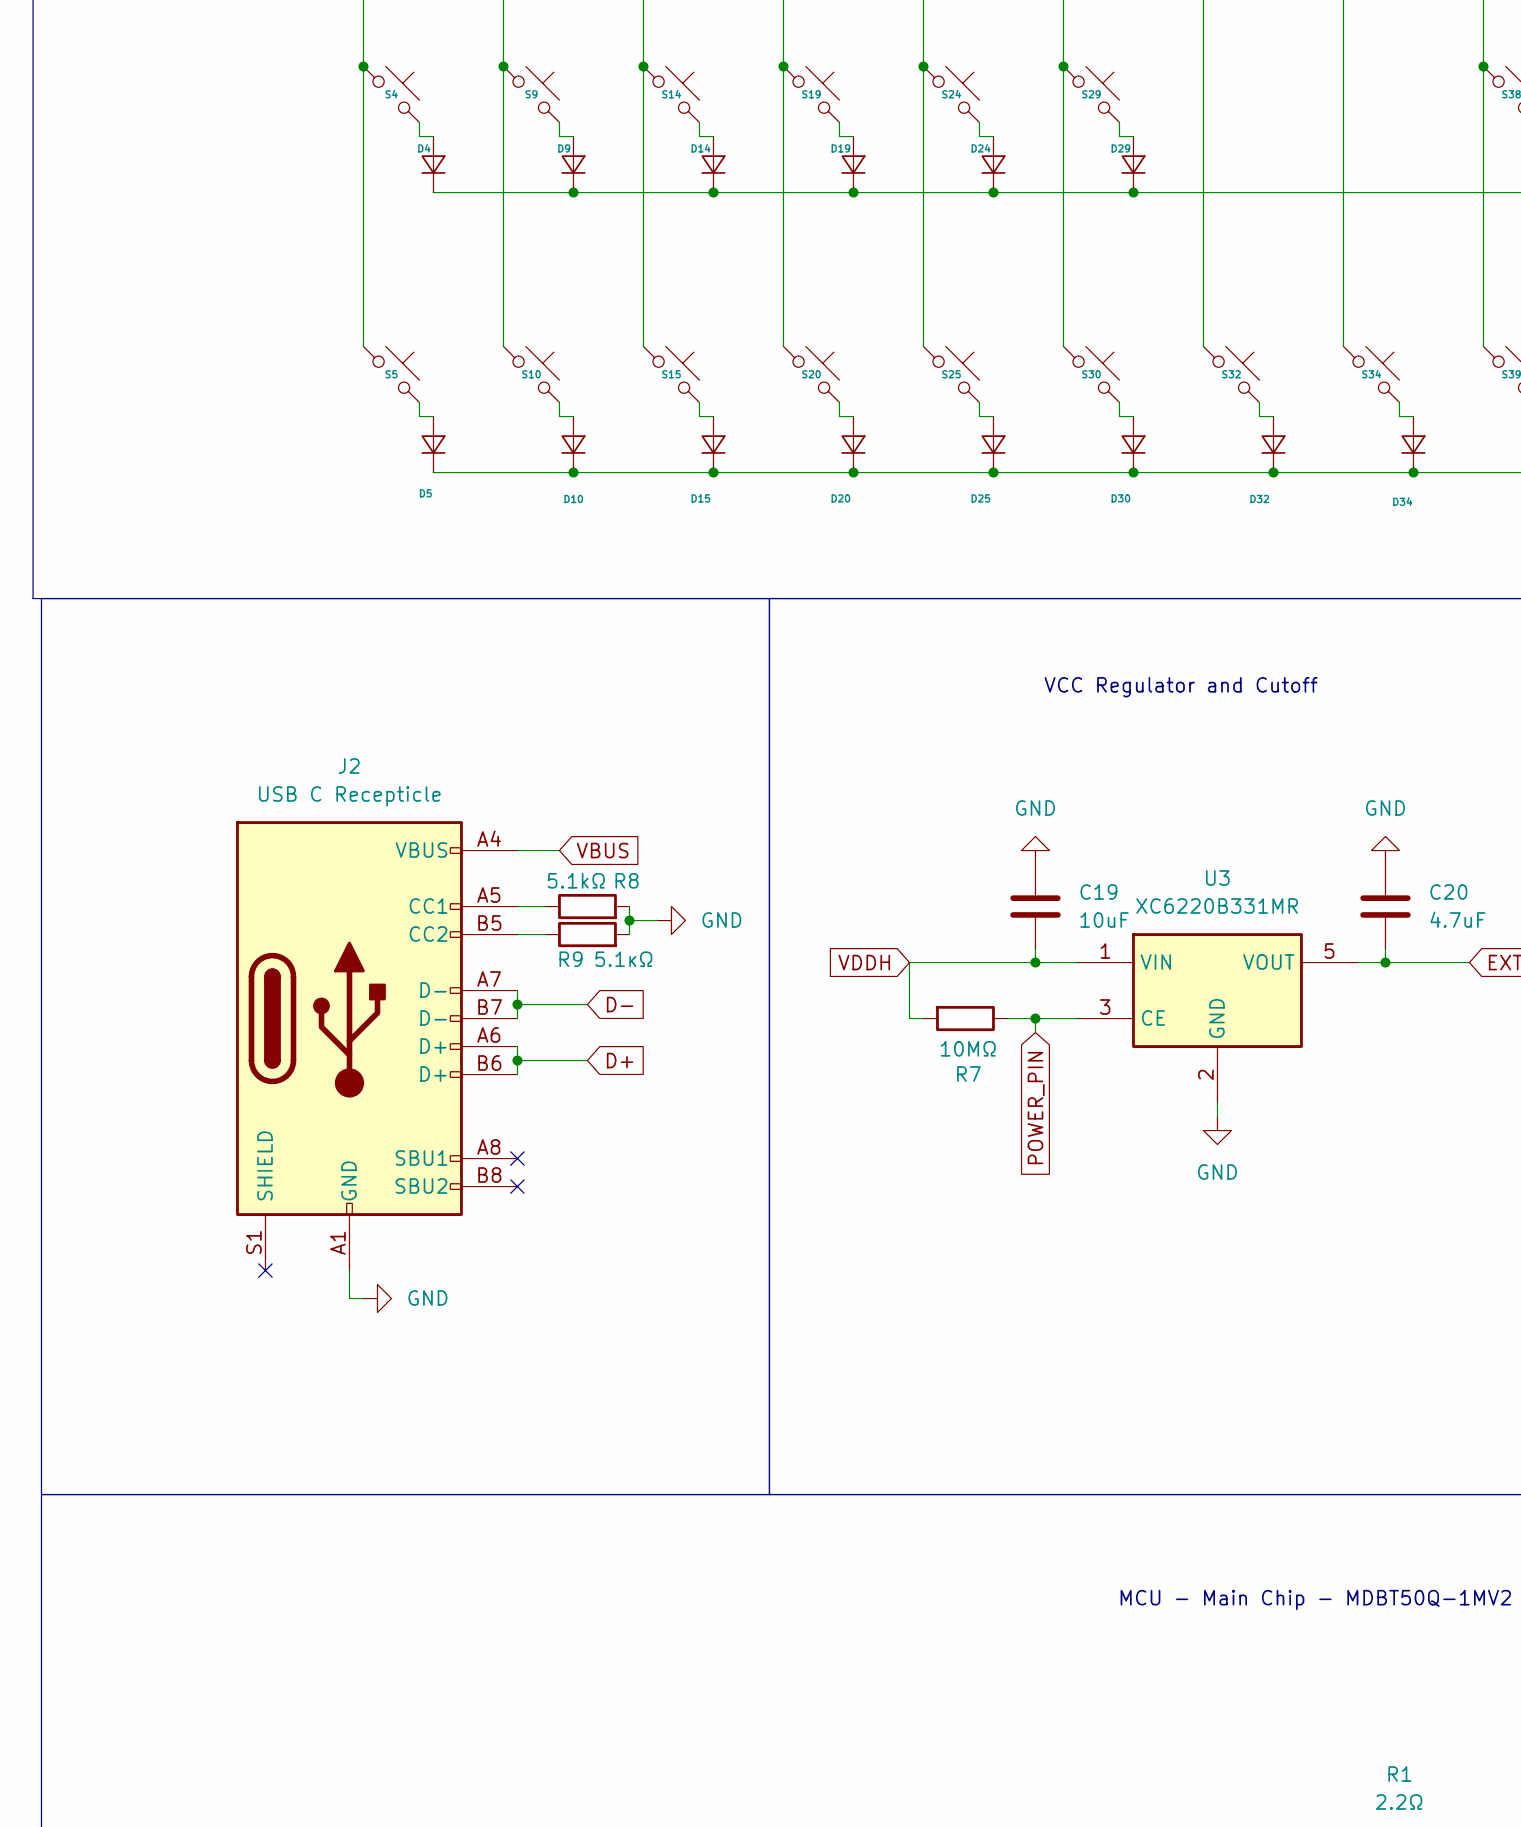
[picture p12: schematic CyberdeckKeyboard.kicad_sch, part in row 2, column 1]

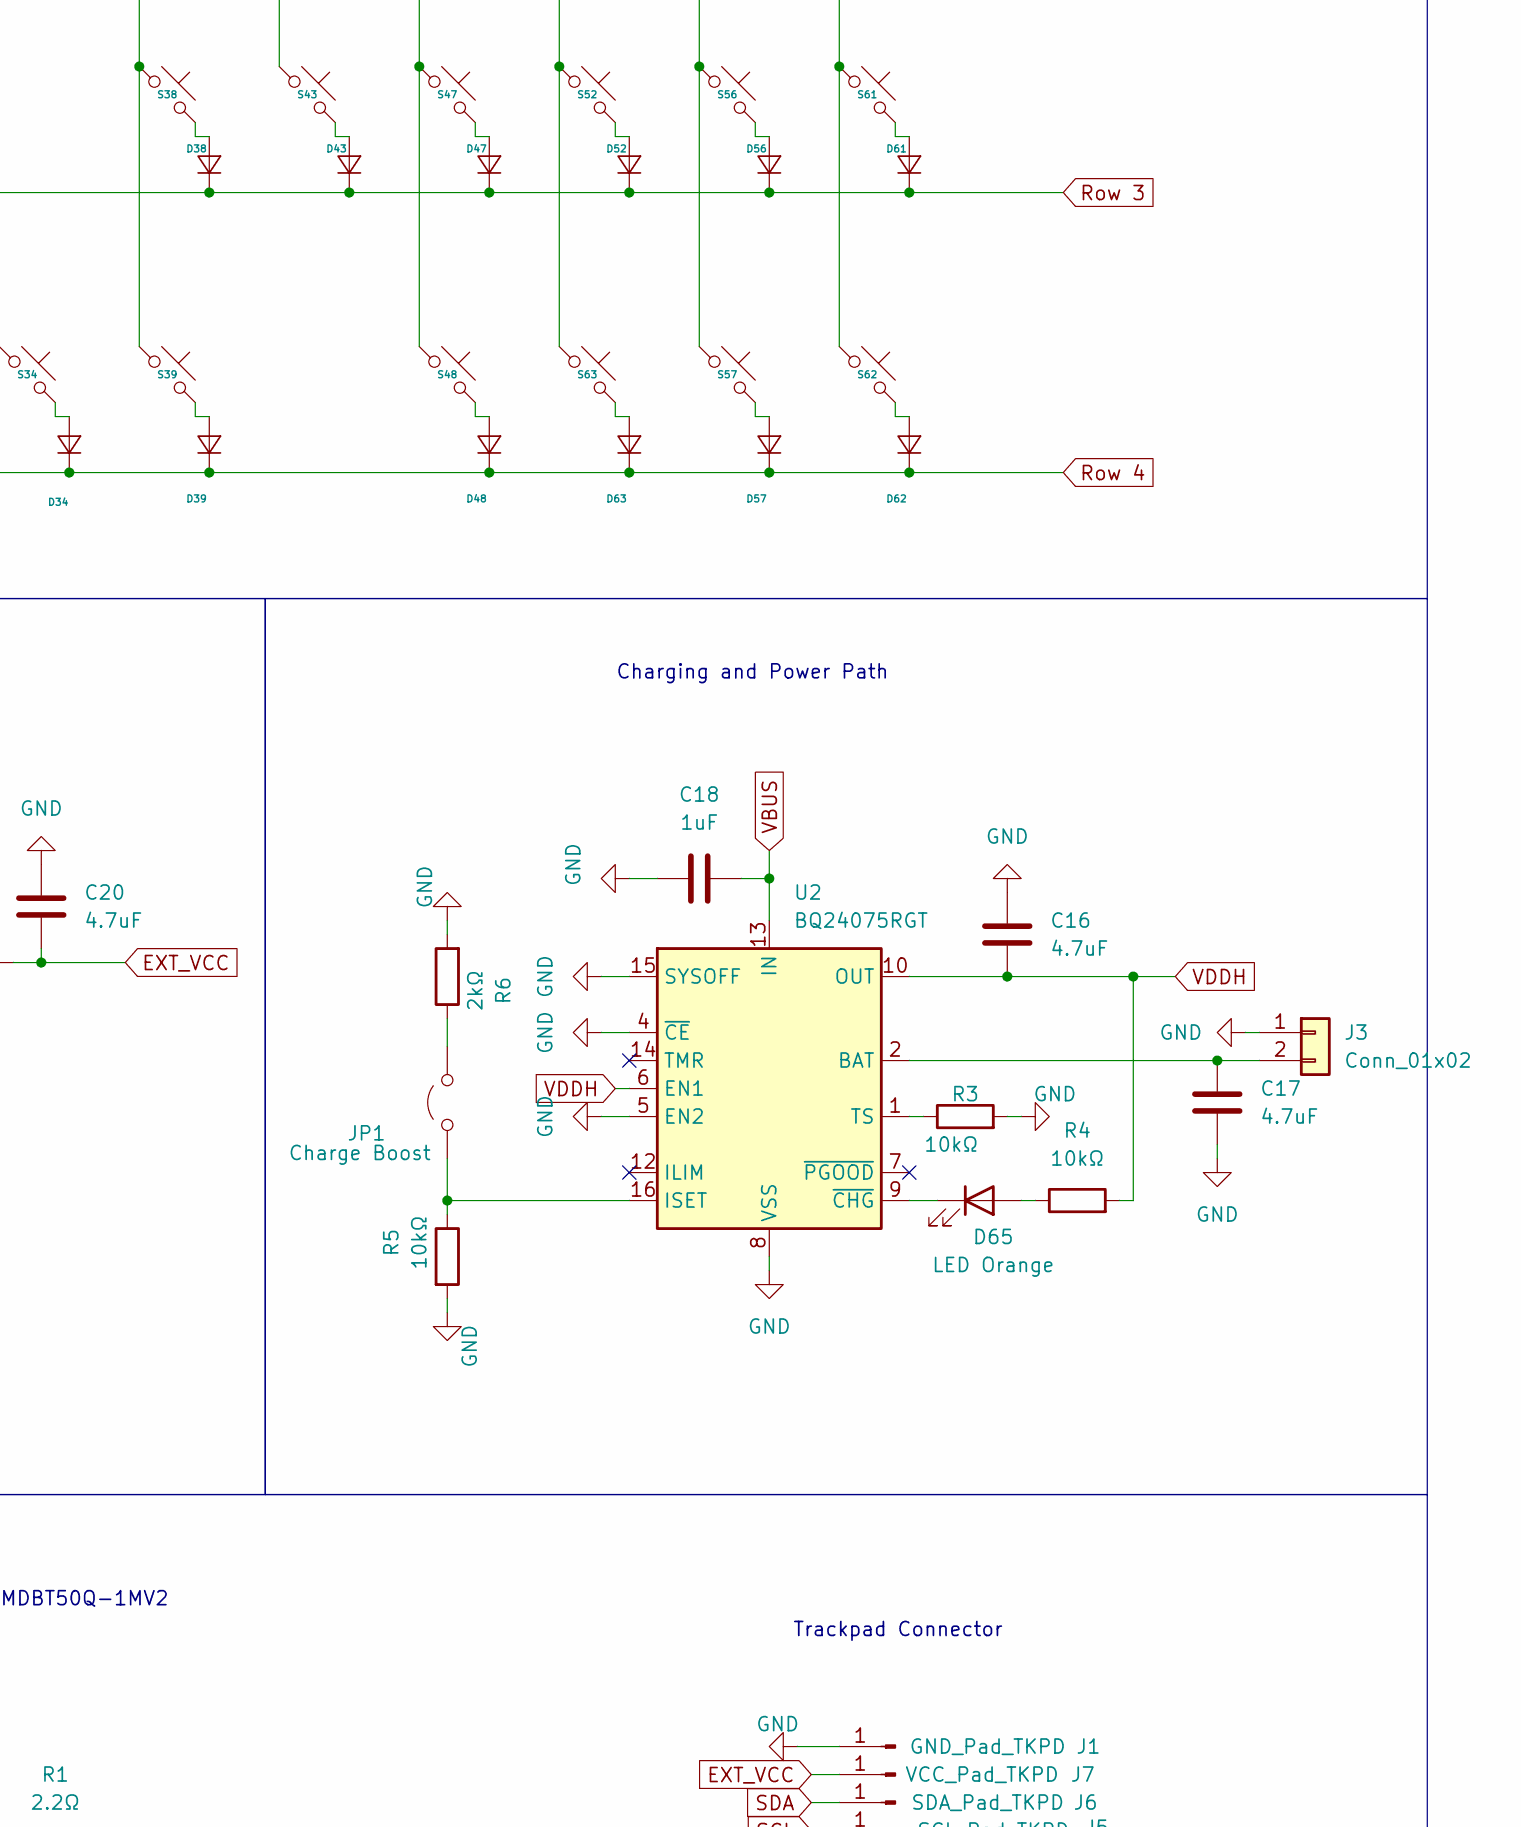
[picture p13: schematic CyberdeckKeyboard.kicad_sch, part in row 2, column 2]

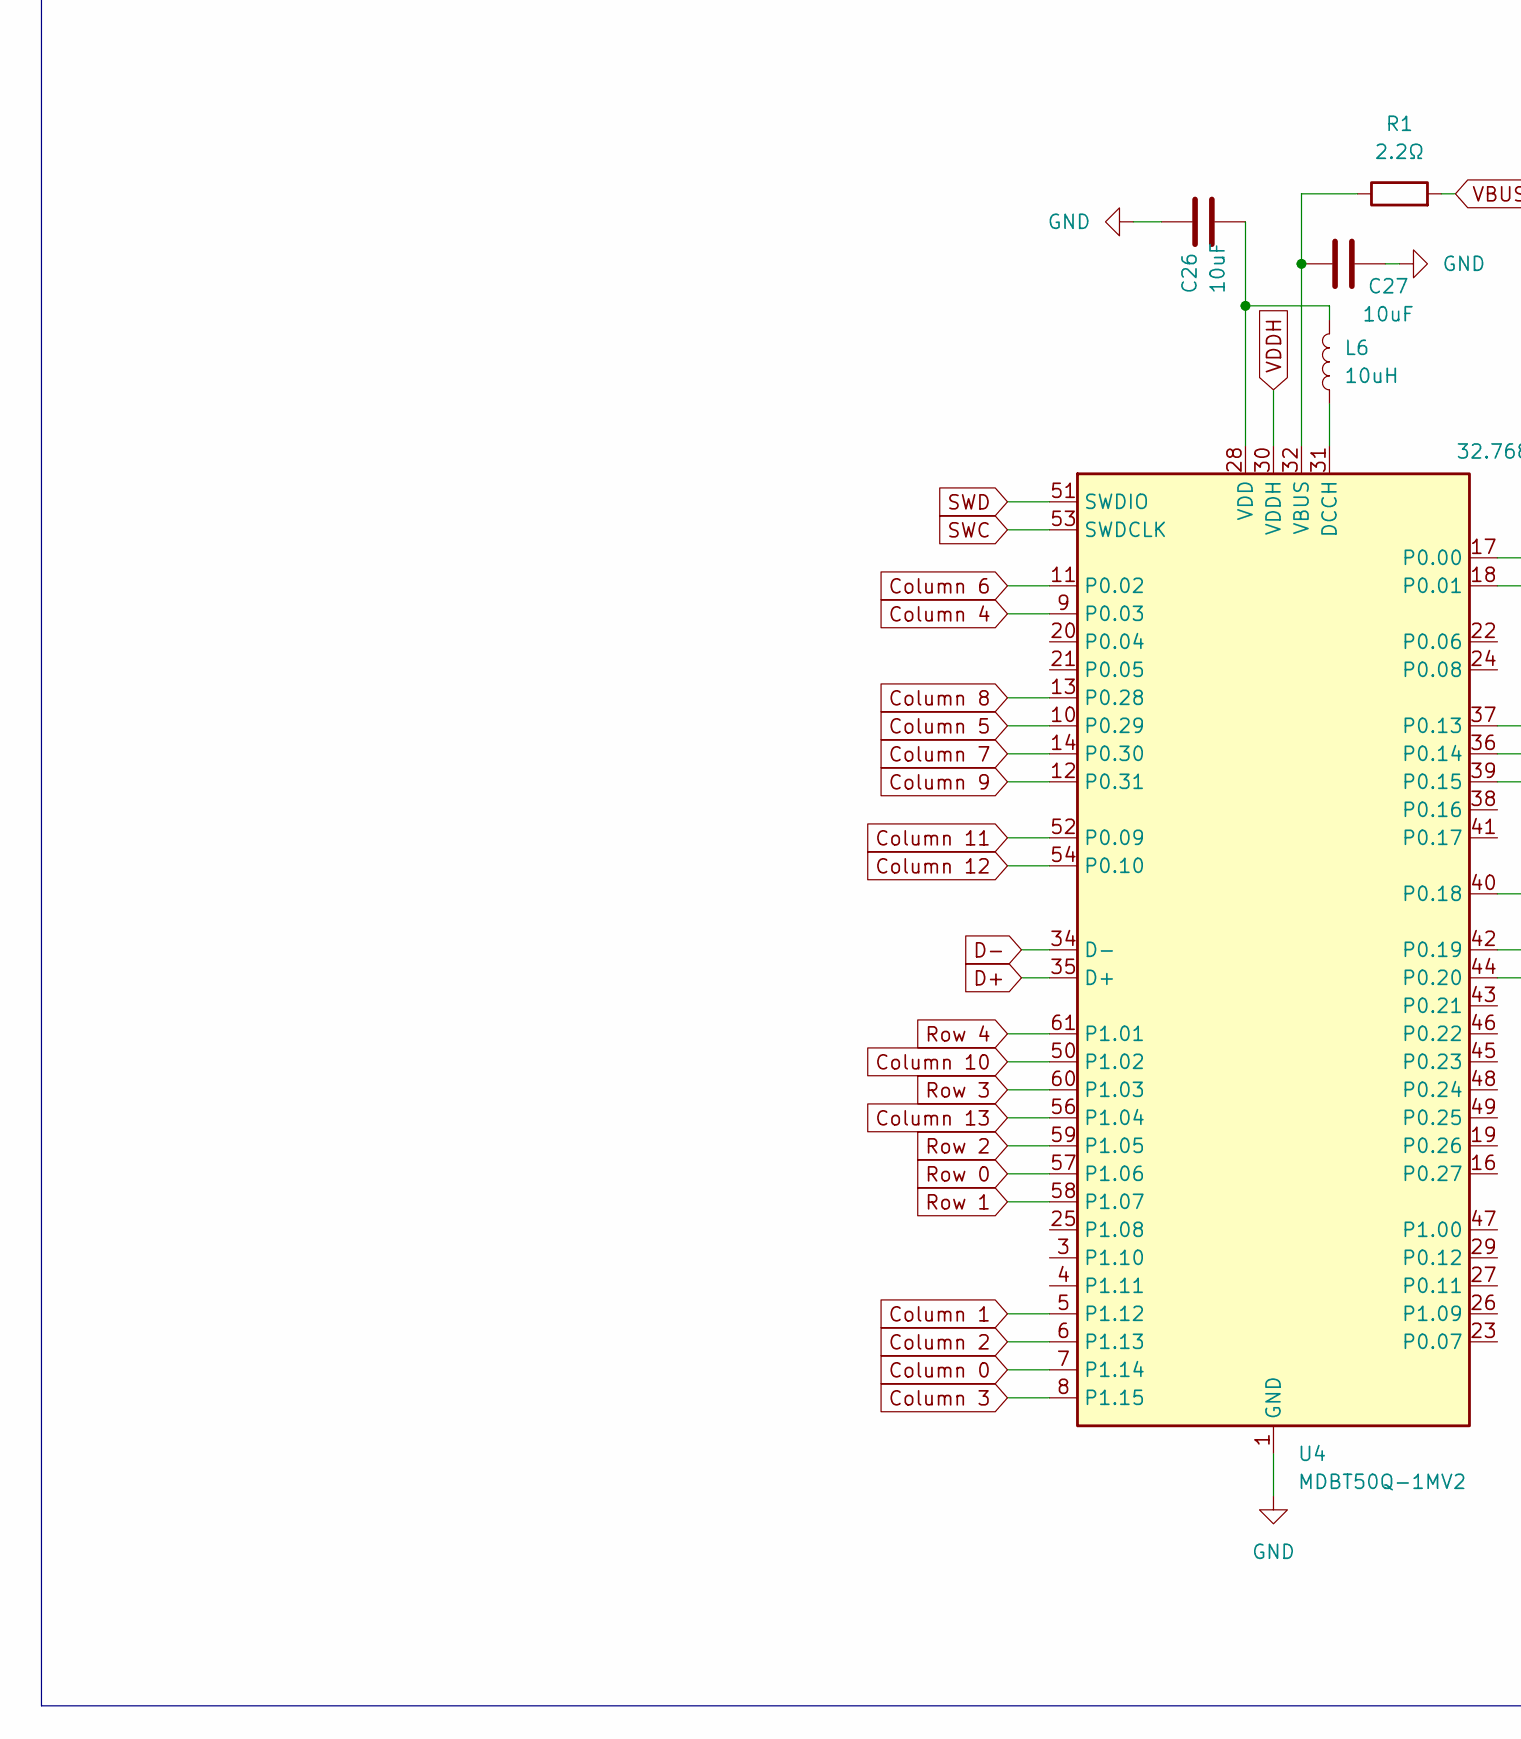
[picture p14: schematic CyberdeckKeyboard.kicad_sch, part in row 3, column 1]

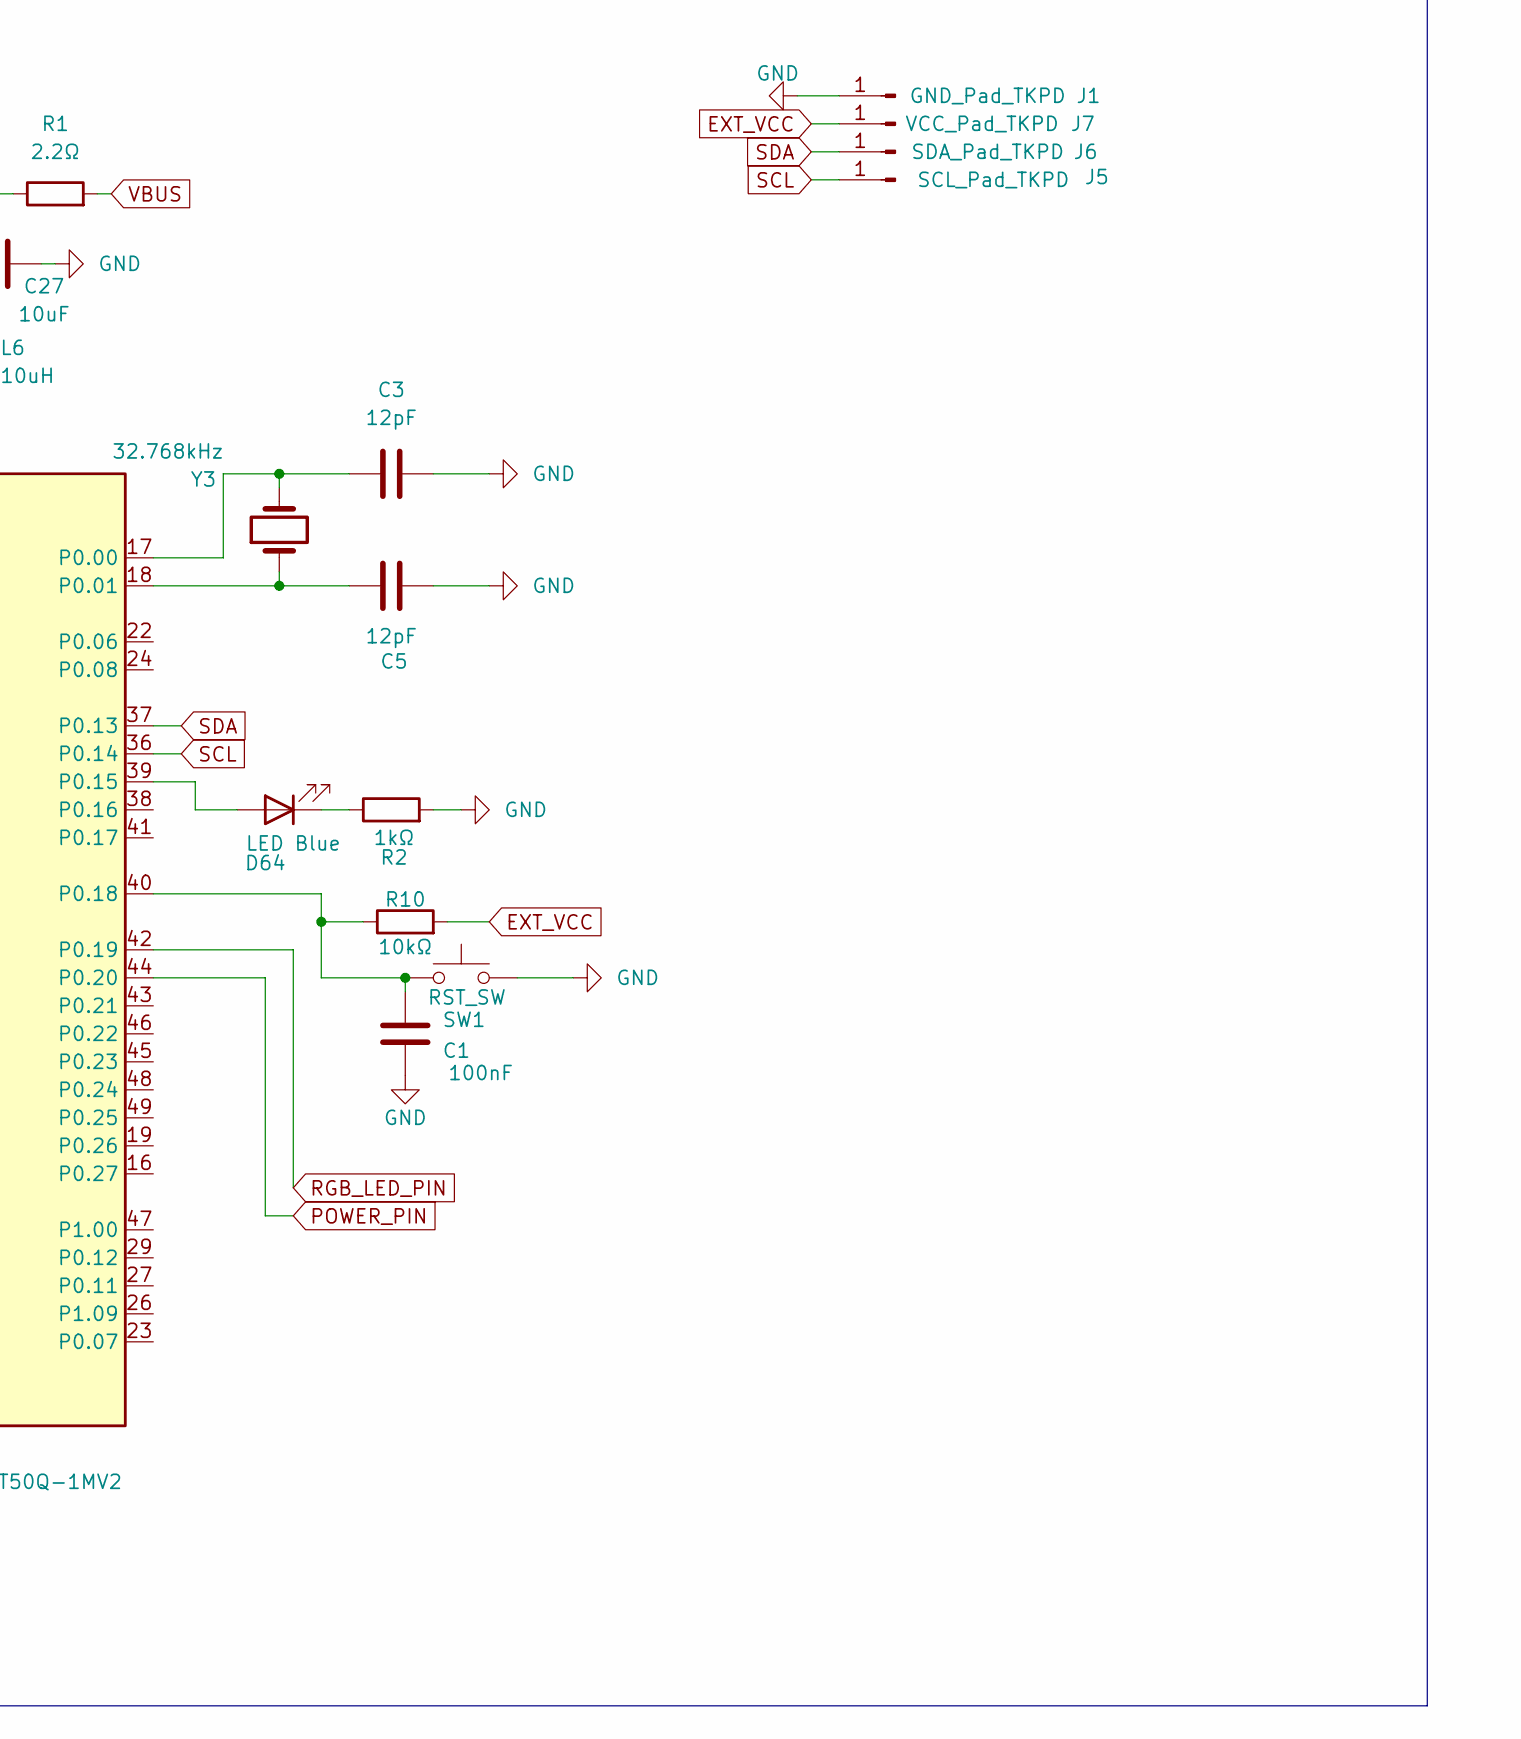
[picture p15: schematic CyberdeckKeyboard.kicad_sch, part in row 3, column 2]

Parts:
C1: 100nF; C_0603_1608Metric
C3, C5: 12pF; C_0603_1608Metric
C16, C17, C20: 4.7uF; C_0603_1608Metric
C18: 1uF; C_0603_1608Metric
C19, C26, C27: 10uF; C_0603_1608Metric
D1, D2, D3, D4, D5, D6, D7, D8, D9, D10, D11, D12, D13, D14, D15, D16, D17, D18, D19, D20, D21, D22, D23, D24, D25, D26, D27, D28, D29, D30, D31, D32, D33, D34, D35, D36, D37, D38, D39, D40, D41, D42, D43, D44, D45, D46, D47, D48, D49, D50, D51, D52, D53, D54, D55, D56, D57, D58, D59, D60, D61, D62, D63: Diode_SOD-123
D64: LED Blue; LED_1206_3216Metric
D65: LED Orange; LED_1206_3216Metric
J1: GND_Pad_TKPD; SolderWirePad_1x01_SMD_2x4mm
J2: USB C Recepticle; USB_C_Receptacle_GCT_USB4105-xx-A_16P_TopMnt_Horizontal
J3: Conn_01x02; JST_PH_B2B-PH-K_1x02_P2.00mm_Vertical
J5: SCL_Pad_TKPD; SolderWirePad_1x01_SMD_2x4mm
J6: SDA_Pad_TKPD; SolderWirePad_1x01_SMD_2x4mm
J7: VCC_Pad_TKPD; SolderWirePad_1x01_SMD_2x4mm
JP1: Charge Boost; SolderJumper-2_P1.3mm_Open_Pad1.0x1.5mm
L6: 10uH; L_0603_1608Metric
R1: 2.2Ω; R_0603_1608Metric
R2: 1kΩ; R_0603_1608Metric
R3, R4, R5, R10: 10kΩ; R_0603_1608Metric
R6: 2kΩ; R_0603_1608Metric
R7: 10MΩ; R_0603_1608Metric
R8: 5.1kΩ; R_0603_1608Metric
R9: 5.1κΩ; R_0603_1608Metric
S1, S2, S3, S4, S5, S6, S7, S8, S9, S10, S11, S12, S13, S14, S15, S16, S17, S18, S19, S20, S21, S22, S23, S24, S25, S26, S27, S28, S29, S30, S31, S33, S35, S36, S37, S38, S39, S40, S41, S42, S43, S44, S45, S46, S47, S48, S49, S50, S51, S52, S53, S54, S55, S56, S57, S58, S59, S60, S61, S62, S63: Choc_V2
S32, S34: SW_PUSH_1P1T_6x3.5mm_H4.3_APEM_MJTP1243
SW1: RST_SW; SW_SPST_CK_RS282G05A3
U2: BQ24075RGT; VQFN-16-1EP_3x3mm_P0.5mm_EP1.6x1.6mm
U3: XC6220B331MR; SOT-23-5
U4: MDBT50Q-1MV2; Raytac_MDBT50Q
Y3: 32.768kHz; Crystal_SMD_2012-2Pin_2.0x1.2mm

Connections:
Column 0: S1.1, S2.1, S3.1, S4.1, S5.1, U4.7 (P1.14)
Column 1: S6.1, S7.1, S8.1, S9.1, S10.1, U4.5 (P1.12)
Column 2: S11.1, S12.1, S13.1, S14.1, S15.1, U4.6 (P1.13)
Column 3: S16.1, S17.1, S18.1, S19.1, S20.1, U4.8 (P1.15)
Column 4: S21.1, S22.1, S23.1, S24.1, S25.1, U4.9 (P0.03)
Column 5: S26.1, S27.1, S28.1, S29.1, S30.1, U4.10 (P0.29)
Column 6: S31.1, S32.1, U4.11 (P0.02)
Column 7: S33.1, S34.1, U4.14 (P0.30)
Column 8: S35.1, S36.1, S37.1, S38.1, S39.1, U4.13 (P0.28)
Column 9: S40.1, S41.1, S42.1, S43.1, U4.12 (P0.31)
Column 10: S44.1, S45.1, S46.1, S47.1, S48.1, U4.50 (P1.02)
Column 11: S49.1, S50.1, S51.1, S52.1, S63.1, U4.52 (P0.09)
Column 12: S53.1, S54.1, S55.1, S56.1, S57.1, U4.54 (P0.10)
Column 13: S58.1, S59.1, S60.1, S61.1, S62.1, U4.56 (P1.04)
D+: J2.A6 (D+), J2.B6 (D+), U4.35 (D+)
D-: J2.A7 (D-), J2.B7 (D-), U4.34 (D-)
EXT_VCC: C20.2, J7.1, R10.2, U3.5 (VOUT)
GND: C1.2, C3.2, C5.2, C16.2, C17.2, C18.2, C19.1, C20.1, C26.1, C27.1, J1.1, J2.A1 (GND), J2.A12 (GND), J2.B1 (GND), J2.B12 (GND), J3.1, R2.2, R3.2, R5.2, R6.2, R8.2, R9.2, SW1.2, U2.4 (~CE), U2.5 (EN2), U2.8 (VSS), U2.15 (SYSOFF), U2.17 (VSS), U3.2 (GND), U4.1 (GND), U4.2 (GND), U4.15 (GND), U4.33 (GND), U4.55 (GND)
unnamed: D1.2 (A), S1.2
unnamed: D2.2 (A), S2.2
unnamed: D3.2 (A), S3.2
unnamed: D4.2 (A), S4.2
unnamed: D5.2 (A), S5.2
unnamed: D6.2 (A), S6.2
unnamed: D7.2 (A), S7.2
unnamed: D8.2 (A), S8.2
unnamed: D9.2 (A), S9.2
unnamed: D10.2 (A), S10.2
unnamed: D11.2 (A), S11.2
unnamed: D12.2 (A), S12.2
unnamed: D13.2 (A), S13.2
unnamed: D14.2 (A), S14.2
unnamed: D15.2 (A), S15.2
unnamed: D16.2 (A), S16.2
unnamed: D17.2 (A), S17.2
unnamed: D18.2 (A), S18.2
unnamed: D19.2 (A), S19.2
unnamed: D20.2 (A), S20.2
unnamed: D21.2 (A), S21.2
unnamed: D22.2 (A), S22.2
unnamed: D23.2 (A), S23.2
unnamed: D24.2 (A), S24.2
unnamed: D25.2 (A), S25.2
unnamed: D26.2 (A), S26.2
unnamed: D27.2 (A), S27.2
unnamed: D28.2 (A), S28.2
unnamed: D29.2 (A), S29.2
unnamed: D30.2 (A), S30.2
unnamed: D31.2 (A), S31.2
unnamed: D32.2 (A), S32.2
unnamed: D33.2 (A), S33.2
unnamed: D34.2 (A), S34.2
unnamed: D35.2 (A), S35.2
unnamed: D36.2 (A), S36.2
unnamed: D37.2 (A), S37.2
unnamed: D38.2 (A), S38.2
unnamed: D39.2 (A), S39.2
unnamed: D40.2 (A), S40.2
unnamed: D41.2 (A), S41.2
unnamed: D42.2 (A), S42.2
unnamed: D43.2 (A), S43.2
unnamed: D44.2 (A), S44.2
unnamed: D45.2 (A), S45.2
unnamed: D46.2 (A), S46.2
unnamed: D47.2 (A), S47.2
unnamed: D48.2 (A), S48.2
unnamed: D49.2 (A), S49.2
unnamed: D50.2 (A), S50.2
unnamed: D51.2 (A), S51.2
unnamed: D52.2 (A), S52.2
unnamed: D53.2 (A), S53.2
unnamed: D54.2 (A), S54.2
unnamed: D55.2 (A), S55.2
unnamed: D56.2 (A), S56.2
unnamed: D57.2 (A), S57.2
unnamed: D58.2 (A), S58.2
unnamed: D59.2 (A), S59.2
unnamed: D60.2 (A), S60.2
unnamed: D61.2 (A), S61.2
unnamed: D62.2 (A), S62.2
unnamed: D63.2 (A), S63.2
unnamed: D64.2 (A), U4.39 (P0.15)
unnamed: D64.1 (K), R2.1
unnamed: D65.2 (A), R4.1
unnamed: D65.1 (K), U2.9 (~CHG)
unnamed: J2.A5 (CC1), R8.1
unnamed: J2.B5 (CC2), R9.1
unnamed: C17.1, J3.2, U2.2 (BAT), U2.3 (BAT)
unnamed: JP1.1 (A), R5.1, U2.16 (ISET)
unnamed: JP1.2 (B), R6.1
unnamed: R3.1, U2.1 (TS)
unnamed: L6.1, U4.31 (DCCH)
unnamed: C3.1, U4.17 (P0.00), Y3.2
unnamed: C5.1, U4.18 (P0.01), Y3.1
unnamed: C1.1, R10.1, SW1.1, U4.40 (P0.18)
unnamed: C27.2, R1.1, U4.32 (VBUS)
unnamed: C26.2, L6.2, U4.28 (VDD)
POWER_PIN: R7.1, U3.3 (CE), U4.44 (P0.20)
RGB_LED_PIN: U4.42 (P0.19)
Row 0: D1.1 (K), D6.1 (K), D11.1 (K), D16.1 (K), D21.1 (K), D26.1 (K), D31.1 (K), D33.1 (K), D35.1 (K), D40.1 (K), D44.1 (K), D49.1 (K), D53.1 (K), D58.1 (K), U4.57 (P1.06)
Row 1: D2.1 (K), D7.1 (K), D12.1 (K), D17.1 (K), D22.1 (K), D27.1 (K), D36.1 (K), D41.1 (K), D45.1 (K), D50.1 (K), D54.1 (K), D59.1 (K), U4.58 (P1.07)
Row 2: D3.1 (K), D8.1 (K), D13.1 (K), D18.1 (K), D23.1 (K), D28.1 (K), D37.1 (K), D42.1 (K), D46.1 (K), D51.1 (K), D55.1 (K), D60.1 (K), U4.59 (P1.05)
Row 3: D4.1 (K), D9.1 (K), D14.1 (K), D19.1 (K), D24.1 (K), D29.1 (K), D38.1 (K), D43.1 (K), D47.1 (K), D52.1 (K), D56.1 (K), D61.1 (K), U4.60 (P1.03)
Row 4: D5.1 (K), D10.1 (K), D15.1 (K), D20.1 (K), D25.1 (K), D30.1 (K), D32.1 (K), D34.1 (K), D39.1 (K), D48.1 (K), D57.1 (K), D62.1 (K), D63.1 (K), U4.61 (P1.01)
SCL: J5.1, U4.36 (P0.14)
SDA: J6.1, U4.37 (P0.13)
SWC: U4.53 (SWDCLK)
SWD: U4.51 (SWDIO)
VBUS: C18.1, J2.A4 (VBUS), J2.A9 (VBUS), J2.B4 (VBUS), J2.B9 (VBUS), R1.2, U2.13 (IN)
VDDH: C16.1, C19.2, R4.2, R7.2, U2.6 (EN1), U2.10 (OUT), U2.11 (OUT), U3.1 (VIN), U4.30 (VDDH)

Notes on the sheet:
Keyboard Matrix
Charging and Power Path
VCC Regulator and Cutoff
Trackpad Connector
MCU - Main Chip - MDBT50Q-1MV2

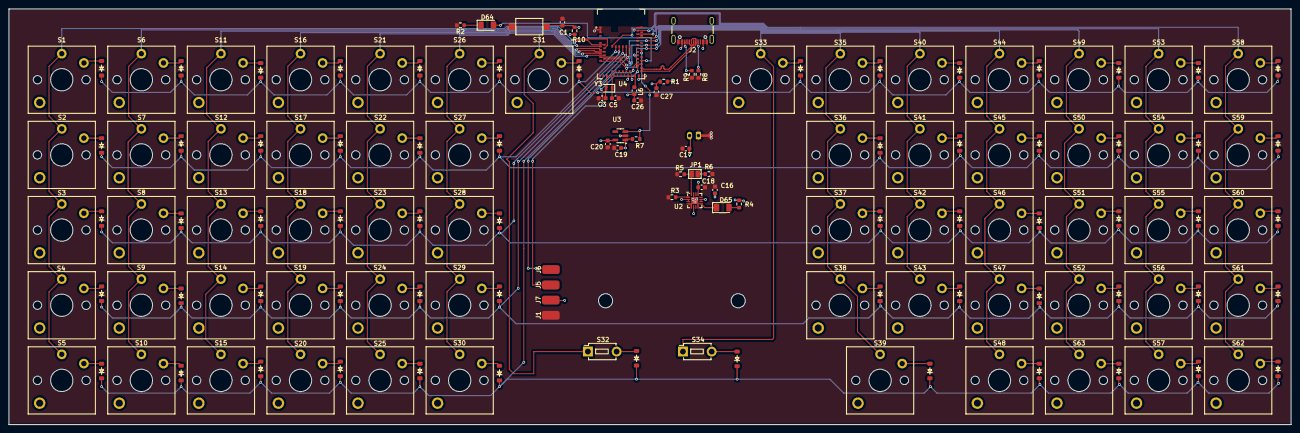
[picture p16: board CyberdeckKeyboard.kicad_pcb from above]

Board: 4 copper layers, 290.0 x 94.0 mm, 161 parts (1 on the bottom side), 107 nets.
