arsia452/Cyberdeck_TD/(commit log)

2026-10-16 Add files via upload
    Added keyboard PCB and step files
2026-10-16 Add files via upload
    Uploaded main Cyberdeck_TD Kicad files (1/2)
2026-10-16 Uploaded main Cyberdeck TD KiCad files (2/2)
2026-10-22 Added .zip of carrier PCB
2026-10-23 Changed keyboard PCB
2026-10-26 Updated Keyboard PCB
2026-10-26 Update README.md
    Added skew and length for all critical HSIO traces
2026-10-26 Keyboard PCB updated
